Louis-Lhl/ECEN405_D_class_amp/schematic/input/inputStage.png

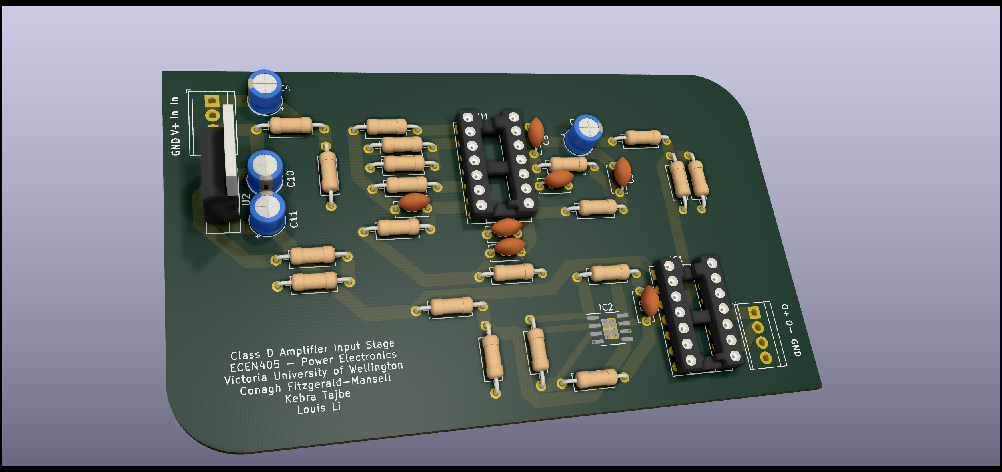
schematic/input/inputStage.png
