Louis-Lhl/ECEN405_D_class_amp/schematic/power/README.md

# Schematic

This folder contains the schematic and PCB layout files and the PCB Gerber files of the power amplifier. These were created using [Kicad](https://www.kicad.org/).

* The PCB Gerbers is [here]().
* The BOM is [here](power_ver_2.0/power_ver_2.0.csv).
