Louis-Lhl/ECEN405_D_class_amp/schematic/power/power_ver_2.0/power_ver_2.0.xlsx

Id;"Designator";"Package";"Quantity";"Designation";"Supplier and ref";
1;"C11 | C3";"C_Disc_D3.8mm_W2.6mm_P2.50mm";2;"SR205C104MAATR1";;;
2;"C10 | C2";"C_Disc_D3.8mm_W2.6mm_P2.50mm";2;"C324C106K3R5TA";;;
3;"C6 | C9 | C7";"C_Radial_D10.0mm_H12.5mm_P5.00mm";3;"uF";;;
4;"TP4 | TP3 | TP2 | TP1";"TestPoint_THTPad_D2.0mm_Drill1.0mm";4;"TestPoint";;;
5;"H4 | H3 | H2 | H1";"MountingHole_4.3mm_M4";4;"MountingHole";;;
6;"C8";"CP_Radial_D12.5mm_P5.00mm";1;"EEU-FC1H102L";;;
7;"R11 | R10";"R_Axial_DIN0207_L6.3mm_D2.5mm_P10.16mm_Horizontal";2;"470";;;
8;"R9 | R8 | R3 | R2";"R_Axial_DIN0207_L6.3mm_D2.5mm_P10.16mm_Horizontal";4;"100";;;
9;"R7 | R6 | R5 | R4";"R_Axial_DIN0207_L6.3mm_D2.5mm_P10.16mm_Horizontal";4;"10k";;;
10;"R1";"R_Axial_DIN0207_L6.3mm_D2.5mm_P10.16mm_Horizontal";1;"1K";;;
11;"L2 | L1";"L_Toroid_Vertical_L24.6mm_W15.5mm_P11.44mm_Pulse_KM-4";2;"2216-V-RC";;;
12;"J4";"TerminalBlock_Altech_AK300-2_P5.00mm";1;"Driver_power";;;
13;"J3";"TerminalBlock_Altech_AK300-2_P5.00mm";1;"Amp_Power";;;
14;"J2";"TerminalBlock_Altech_AK300-2_P5.00mm";1;"Audio OUTPUT";;;
15;"J1";"TerminalBlock_Altech_AK300-2_P5.00mm";1;"PWM INPUT";;;
16;"D6 | D5 | D4 | D3 | D2 | D1";"D_DO-35_SOD27_P7.62mm_Horizontal";6;"1N4148";;;
17;"C5 | C4";"CP_Radial_D6.3mm_P2.50mm";2;"ECE-A1HN100U";;;
18;"C1";"CP_Radial_D10.0mm_P5.00mm";1;"ECE-A1HN101U";;;
19;"Q4 | Q3 | Q2 | Q1";"TO-220-3";4;"IRF530A";;;
20;"U1";"DIP-16_W7.62mm";1;"HIP4082IP";;;
