Louis-Lhl/ECEN405_D_class_amp/results/power_section_measurement/30V_audio_Output/F0006CH1.CSV

Record Length | 2.500000e+03 | -0.012500000000 | -14.80000
Sample Interval | 1.000000e-05 | -0.012490000000 | -15.00000
Trigger Point | 1.250000000000e+03 | -0.012480000000 | -14.60000
 |  | -0.012470000000 | -15.00000
 |  | -0.012460000000 | -15.00000
 |  | -0.012450000000 | -14.60000
Source | CH1 | -0.012440000000 | -15.00000
Vertical Units | V | -0.012430000000 | -15.00000
Vertical Scale | 5.000000e+00 | -0.012420000000 | -14.80000
Vertical Offset | 0.000000e+00 | -0.012410000000 | -14.80000
Horizontal Units | s | -0.012400000000 | -14.80000
Horizontal Scale | 2.500000e-03 | -0.012390000000 | -14.80000
Pt Fmt | Y | -0.012380000000 | -14.60000
Yzero | 0.000000e+00 | -0.012370000000 | -14.80000
Probe Atten | 1.000000e+01 | -0.012360000000 | -14.60000
Model Number | TDS2024B | -0.012350000000 | -14.80000
Serial Number | C046999 | -0.012340000000 | -14.40000
Firmware Version | FV:v22.11 | -0.012330000000 | -14.80000
 |  | -00.012320000000 | -14.60000
 |  | -00.012310000000 | -14.60000
 |  | -00.012300000000 | -14.80000
 |  | -00.012290000000 | -14.60000
 |  | -00.012280000000 | -14.40000
 |  | -00.012270000000 | -14.60000
 |  | -00.012260000000 | -14.60000
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
