Louis-Lhl/ECEN405_D_class_amp/results/power_section_measurement/ALL0012/F0012CH1.CSV

Record Length | 2.500000e+03 | -0.012500000000 | -0.04000
Sample Interval | 1.000000e-05 | -0.012490000000 | -0.08000
Trigger Point | 1.250000000000e+03 | -0.012480000000 | -0.16000
 |  | -0.012470000000 | -0.16000
 |  | -0.012460000000 | -0.20000
 |  | -0.012450000000 | -0.12000
Source | CH1 | -0.012440000000 | -0.24000
Vertical Units | V | -0.012430000000 | -0.28000
Vertical Scale | 1.000000e+00 | -0.012420000000 | -0.28000
Vertical Offset | 4.000000e-02 | -0.012410000000 | -0.32000
Horizontal Units | s | -0.012400000000 | -0.36000
Horizontal Scale | 2.500000e-03 | -0.012390000000 | -0.36000
Pt Fmt | Y | -0.012380000000 | -0.40000
Yzero | 0.000000e+00 | -0.012370000000 | -0.44000
Probe Atten | 1.000000e+01 | -0.012360000000 | -0.44000
Model Number | TDS2024B | -0.012350000000 | -0.48000
Serial Number | C046999 | -0.012340000000 | -0.52000
Firmware Version | FV:v22.11 | -0.012330000000 | -0.52000
 |  | -00.012320000000 | -0.56000
 |  | -00.012310000000 | -0.68000
 |  | -00.012300000000 | -0.60000
 |  | -00.012290000000 | -0.64000
 |  | -00.012280000000 | -0.68000
 |  | -00.012270000000 | -0.72000
 |  | -00.012260000000 | -0.72000
 |  | -00.012250000000 | -0.76000
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
