Louis-Lhl/ECEN405_D_class_amp/results/power_section_measurement/ALL0013/F0013CH1.CSV

Record Length | 2.500000e+03 | -0.002500000000 | -0.08000
Sample Interval | 2.000000e-06 | -0.002498000000 | -0.08000
Trigger Point | 1.250000000000e+03 | -0.002496000000 | -0.08000
 |  | -0.002494000000 | -0.08000
 |  | -0.002492000000 | -0.08000
 |  | -0.002490000000 | -0.12000
Source | CH1 | -0.002488000000 | -0.08000
Vertical Units | V | -0.002486000000 | -0.12000
Vertical Scale | 1.000000e+00 | -0.002484000000 | -0.12000
Vertical Offset | 4.000000e-02 | -0.002482000000 | -0.12000
Horizontal Units | s | -0.002480000000 | -0.12000
Horizontal Scale | 5.000000e-04 | -0.002478000000 | -0.12000
Pt Fmt | Y | -0.002476000000 | -0.08000
Yzero | 0.000000e+00 | -0.002474000000 | -0.12000
Probe Atten | 1.000000e+01 | -0.002472000000 | -0.16000
Model Number | TDS2024B | -0.002470000000 | -0.16000
Serial Number | C046999 | -0.002468000000 | -0.12000
Firmware Version | FV:v22.11 | -0.002466000000 | -0.12000
 |  | -00.002464000000 | -0.16000
 |  | -00.002462000000 | -0.20000
 |  | -00.002460000000 | -0.20000
 |  | -00.002458000000 | -0.20000
 |  | -00.002456000000 | -0.20000
 |  | -00.002454000000 | -0.16000
 |  | -00.002452000000 | -0.20000
 |  | -00.002450000000 | -0.20000
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
