Louis-Lhl/ECEN405_D_class_amp/results/power_section_measurement/PWM_input/F0004CH1.CSV

Record Length | 2.500000e+03 | -0.000050000000 | 4.40000
Sample Interval | 4.000000e-08 | -0.000049960000 | 4.60000
Trigger Point | 1.250000000000e+03 | -0.000049920000 | 4.80000
 |  | -0.000049880000 | 4.40000
 |  | -0.000049840000 | 4.80000
 |  | -0.000049800000 | 5.00000
Source | CH1 | -0.000049760000 | 4.60000
Vertical Units | V | -0.000049720000 | 4.80000
Vertical Scale | 5.000000e+00 | -0.000049680000 | 4.80000
Vertical Offset | 1.000000e+01 | -0.000049640000 | 4.80000
Horizontal Units | s | -0.000049600000 | 4.80000
Horizontal Scale | 1.000000e-05 | -0.000049560000 | 4.60000
Pt Fmt | Y | -0.000049520000 | 4.80000
Yzero | 0.000000e+00 | -0.000049480000 | 4.80000
Probe Atten | 1.000000e+01 | -0.000049440000 | 5.00000
Model Number | TDS2024B | -0.000049400000 | 5.00000
Serial Number | C046999 | -0.000049360000 | 4.80000
Firmware Version | FV:v22.11 | -0.000049320000 | 4.60000
 |  | -00.000049280000 | 4.80000
 |  | -00.000049240000 | 5.00000
 |  | -00.000049200000 | 4.60000
 |  | -00.000049160000 | 4.60000
 |  | -00.000049120000 | 4.80000
 |  | -00.000049080000 | 5.00000
 |  | -00.000049040000 | 4.80000
 |  | -00.000049000000 | 4.60000
 |  | -00.000048960000 | 4.60000
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
