Louis-Lhl/ECEN405_D_class_amp/results/power_section_measurement/PWM_input/F0004CH2.CSV

Record Length | 2.500000e+03 | -0.000050000000 | 0.20000
Sample Interval | 4.000000e-08 | -0.000049960000 | 0.20000
Trigger Point | 1.250000000000e+03 | -0.000049920000 | 0.40000
 |  | -0.000049880000 | 0.60000
 |  | -0.000049840000 | 0.60000
 |  | -0.000049800000 | 0.20000
Source | CH2 | -0.000049760000 | 0.00000
Vertical Units | A | -0.000049720000 | -0.20000
Vertical Scale | 5.000000e+00 | -0.000049680000 | 0.20000
Vertical Offset | -1.000000e+01 | -0.000049640000 | 0.40000
Horizontal Units | s | -0.000049600000 | 0.20000
Horizontal Scale | 1.000000e-05 | -0.000049560000 | 0.40000
Pt Fmt | Y | -0.000049520000 | 0.20000
Yzero | 0.000000e+00 | -0.000049480000 | 0.40000
Probe Atten | 1.000000e+01 | -0.000049440000 | 0.20000
Model Number | TDS2024B | -0.000049400000 | 0.40000
Serial Number | C046999 | -0.000049360000 | 0.20000
Firmware Version | FV:v22.11 | -0.000049320000 | 0.00000
 |  | -00.000049280000 | 0.20000
 |  | -00.000049240000 | 0.00000
 |  | -00.000049200000 | 0.40000
 |  | -00.000049160000 | 0.00000
 |  | -00.000049120000 | 0.40000
 |  | -00.000049080000 | 0.40000
 |  | -00.000049040000 | 0.20000
 |  | -00.000049000000 | 0.20000
 |  | -00.000048960000 | 0.60000
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
