Louis-Lhl/ECEN405_D_class_amp/results/power_section_measurement/PWM_output_across_load/F0015CH1.CSV

Record Length | 2.500000e+03 | -0.000012500000 | 12.80000
Sample Interval | 1.000000e-08 | -0.000012490000 | 13.60000
Trigger Point | 1.250000000000e+03 | -0.000012480000 | 13.60000
 |  | -0.000012470000 | 14.40000
 |  | -0.000012460000 | 13.60000
 |  | -0.000012450000 | 13.60000
Source | CH1 | -0.000012440000 | 14.40000
Vertical Units | V | -0.000012430000 | 14.40000
Vertical Scale | 2.000000e+01 | -0.000012420000 | 13.60000
Vertical Offset | 0.000000e+00 | -0.000012410000 | 14.40000
Horizontal Units | s | -0.000012400000 | 13.60000
Horizontal Scale | 2.500000e-06 | -0.000012390000 | 14.40000
Pt Fmt | Y | -0.000012380000 | 14.40000
Yzero | 0.000000e+00 | -0.000012370000 | 15.20000
Probe Atten | 1.000000e+01 | -0.000012360000 | 13.60000
Model Number | TDS2024B | -0.000012350000 | 12.80000
Serial Number | C046999 | -0.000012340000 | 13.60000
Firmware Version | FV:v22.11 | -0.000012330000 | 13.60000
 |  | -00.000012320000 | 14.40000
 |  | -00.000012310000 | 13.60000
 |  | -00.000012300000 | 13.60000
 |  | -00.000012290000 | 13.60000
 |  | -00.000012280000 | 14.40000
 |  | -00.000012270000 | 14.40000
 |  | -00.000012260000 | 13.60000
 |  | -00.000012250000 | 14.40000
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
