Louis-Lhl/ECEN405_D_class_amp/results/inputFilter/250034087_1454181184963633_4800908642251497282_n.jpg

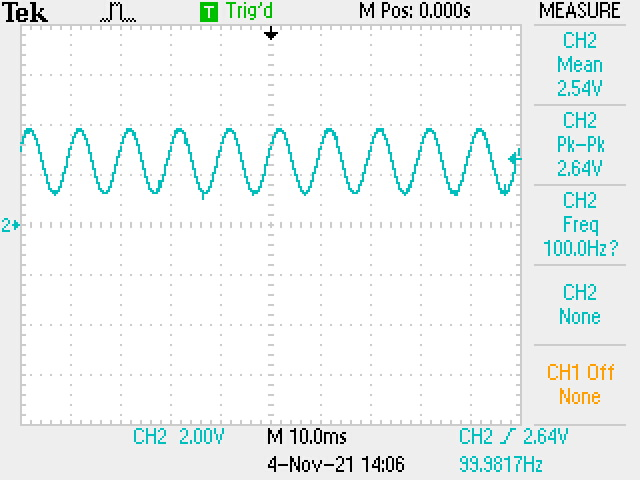
results/inputFilter/250034087_1454181184963633_4800908642251497282_n.jpg
