Louis-Lhl/ECEN405_D_class_amp/results/inputFilter/250767801_211799224394181_3932051920103736763_n.jpg

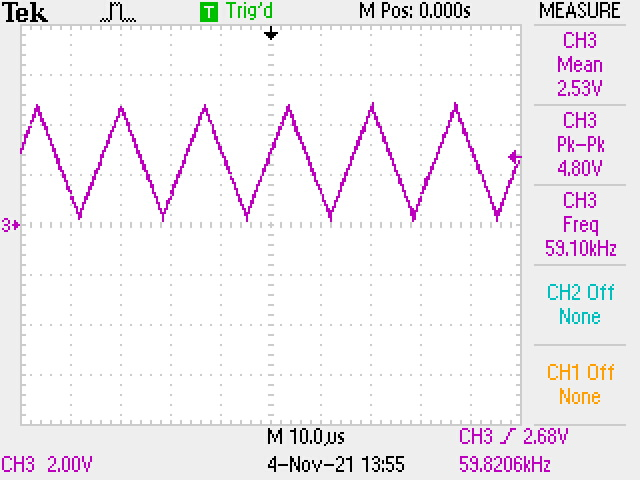
results/inputFilter/250767801_211799224394181_3932051920103736763_n.jpg
