Louis-Lhl/ECEN405_D_class_amp/results/inputFilter/251312043_1243758189444691_4574539768760520797_n.png

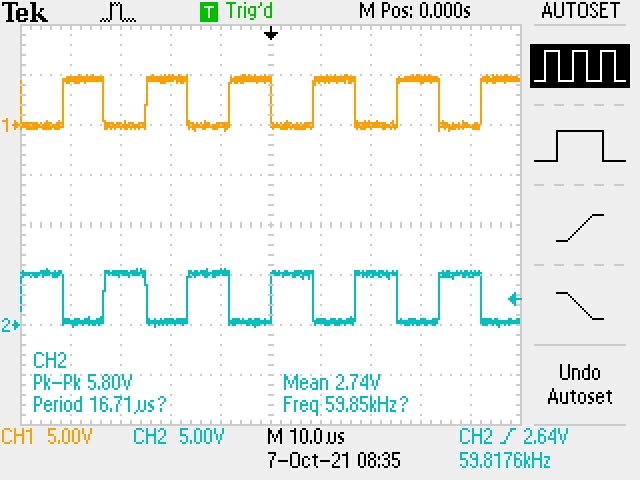
results/inputFilter/251312043_1243758189444691_4574539768760520797_n.png
