Louis-Lhl/ECEN405_D_class_amp/results/inputFilter/251569185_559348848496102_8192376683480866225_n.jpg

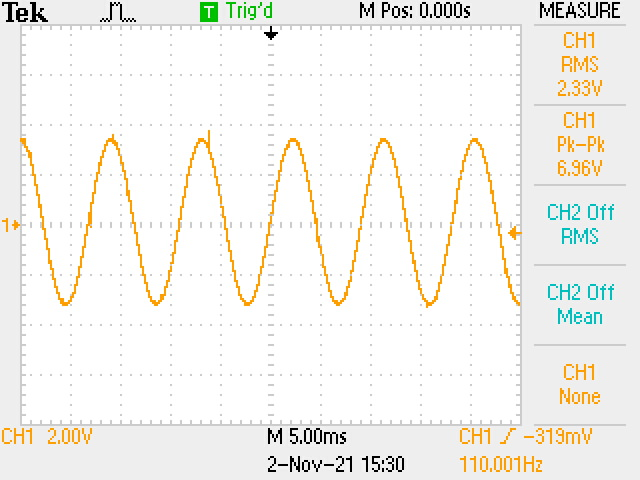
results/inputFilter/251569185_559348848496102_8192376683480866225_n.jpg
