Louis-Lhl/ECEN405_D_class_amp/results/inputFilter/253176706_352466729969639_4853334996477210062_n.jpg

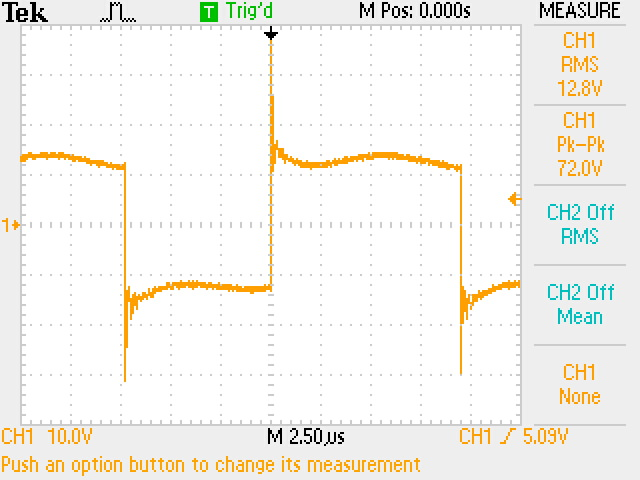
results/inputFilter/253176706_352466729969639_4853334996477210062_n.jpg
