Louis-Lhl/ECEN405_D_class_amp/results/outputFilter/OutputFilter.png

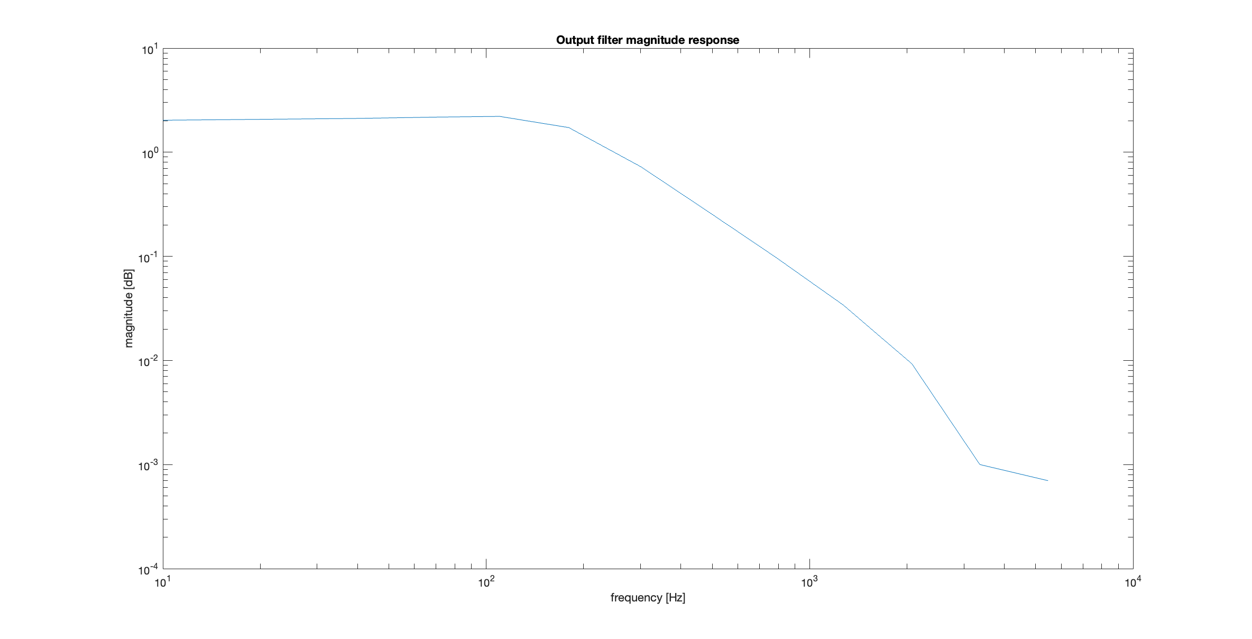
results/outputFilter/OutputFilter.png
