Louis-Lhl/ECEN405_D_class_amp/results/power_section_measurement/30V_audio_Output/F0006TEK.JPG

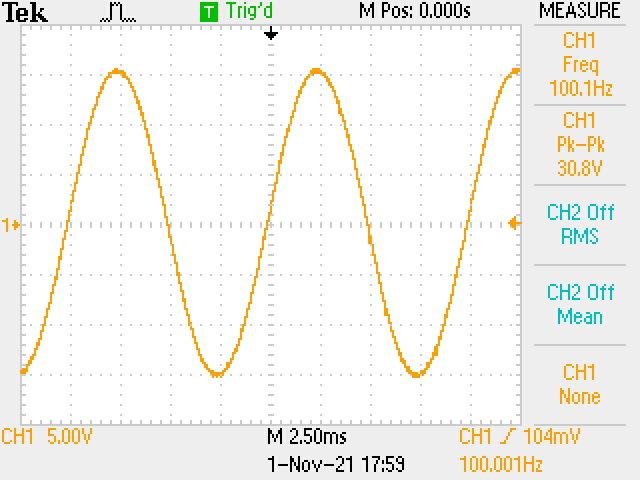
results/power_section_measurement/30V_audio_Output/F0006TEK.JPG
