Louis-Lhl/ECEN405_D_class_amp/results/power_section_measurement/ALL0012/F0012TEK.JPG

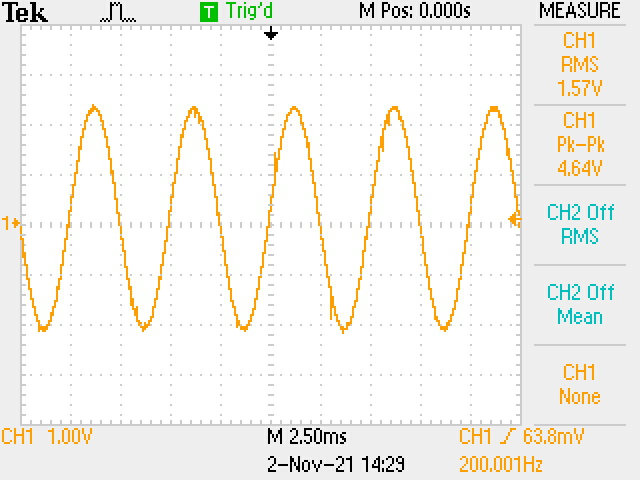
results/power_section_measurement/ALL0012/F0012TEK.JPG
