Louis-Lhl/ECEN405_D_class_amp/results/power_section_measurement/ALL0013/F0013TEK.JPG

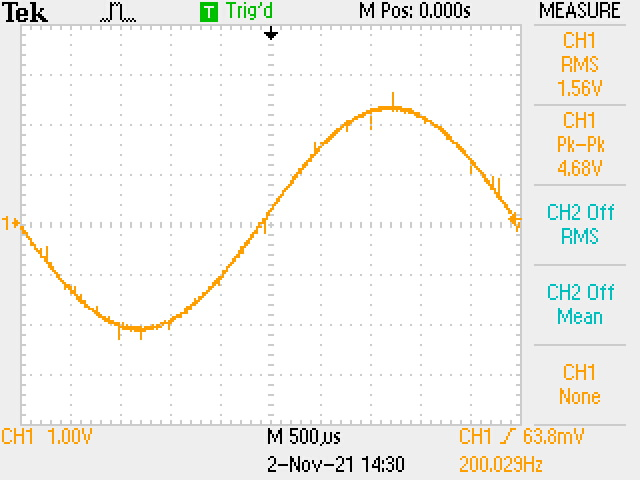
results/power_section_measurement/ALL0013/F0013TEK.JPG
