Louis-Lhl/ECEN405_D_class_amp/results/power_section_measurement/amplified_PWM_output/F0011TEK.JPG

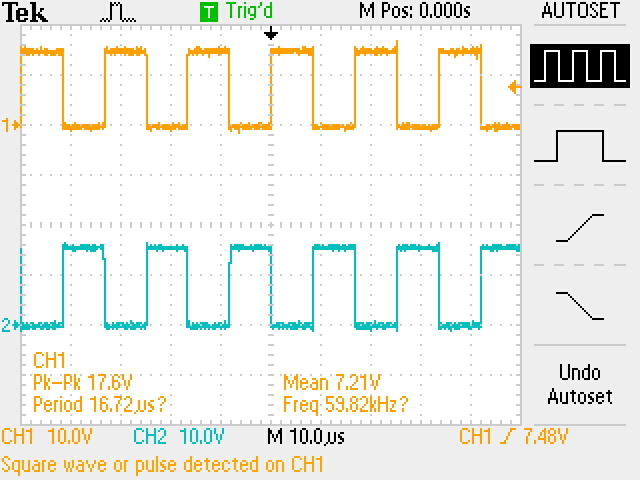
results/power_section_measurement/amplified_PWM_output/F0011TEK.JPG
