Louis-Lhl/ECEN405_D_class_amp/results/power_section_measurement/amplified_PWM_output_overlay/F0007TEK.JPG

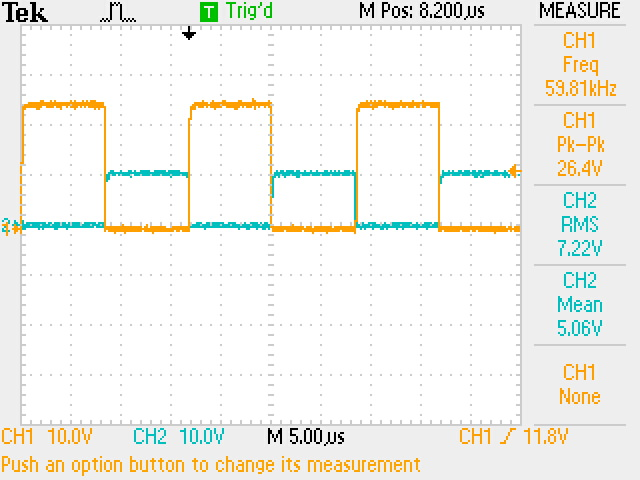
results/power_section_measurement/amplified_PWM_output_overlay/F0007TEK.JPG
