Louis-Lhl/ECEN405_D_class_amp/results/power_section_measurement/audio_output_across_load/F0014TEK.JPG

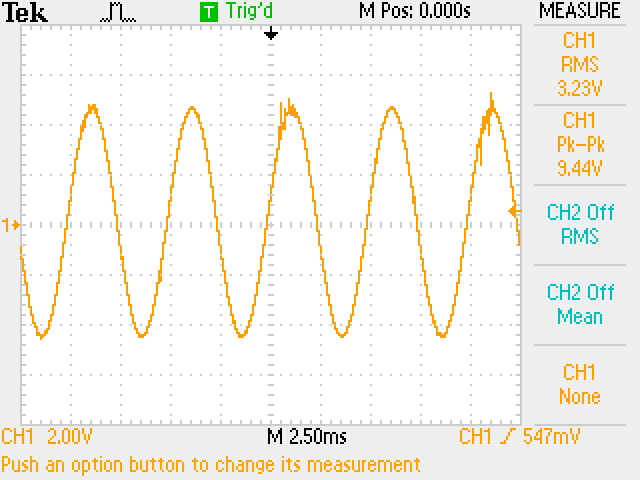
results/power_section_measurement/audio_output_across_load/F0014TEK.JPG
