Louis-Lhl/ECEN405_D_class_amp/results/power_section_measurement/dead_time_1/F0009TEK.JPG

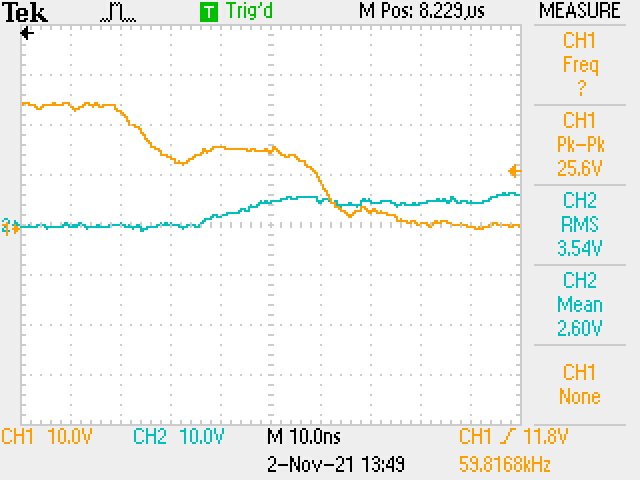
results/power_section_measurement/dead_time_1/F0009TEK.JPG
