Louis-Lhl/ECEN405_D_class_amp/results/power_section_measurement/dead_time_2/F0010TEK.JPG

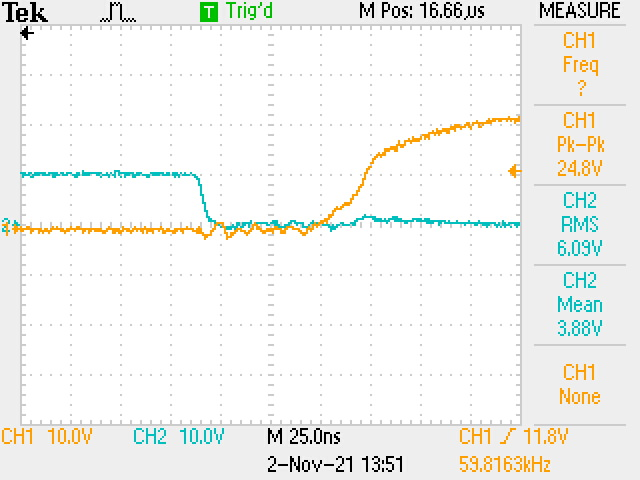
results/power_section_measurement/dead_time_2/F0010TEK.JPG
