Louis-Lhl/ECEN405_D_class_amp/results/power_section_measurement/PWM_input/F0004TEK.JPG

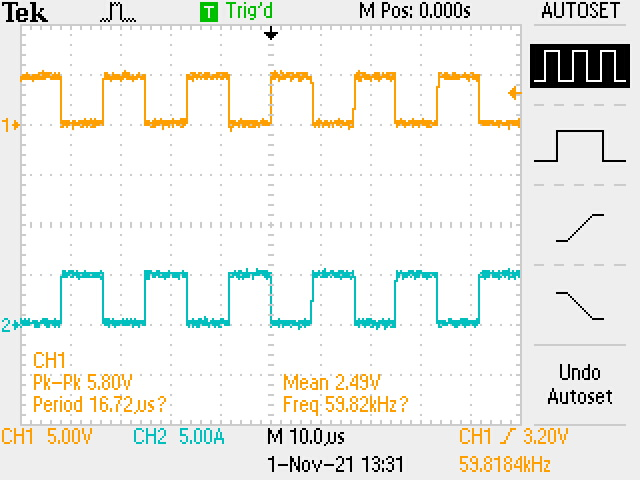
results/power_section_measurement/PWM_input/F0004TEK.JPG
