Louis-Lhl/ECEN405_D_class_amp/results/power_section_measurement/PWM_output_across_load/F0015TEK.JPG

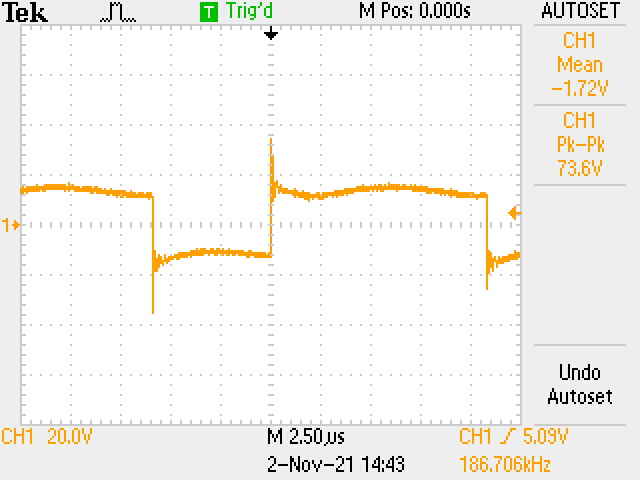
results/power_section_measurement/PWM_output_across_load/F0015TEK.JPG
