Louis-Lhl/ECEN405_D_class_amp/results/system/SystemEff.png

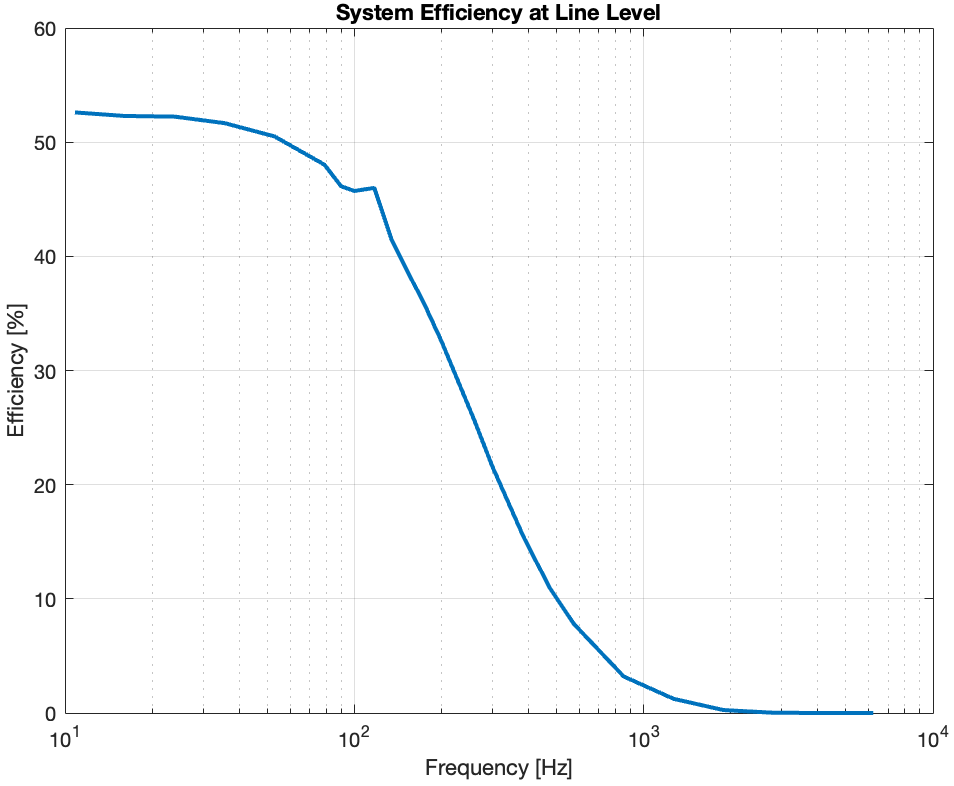
results/system/SystemEff.png
