Louis-Lhl/ECEN405_D_class_amp/results/system/SystemGain.png

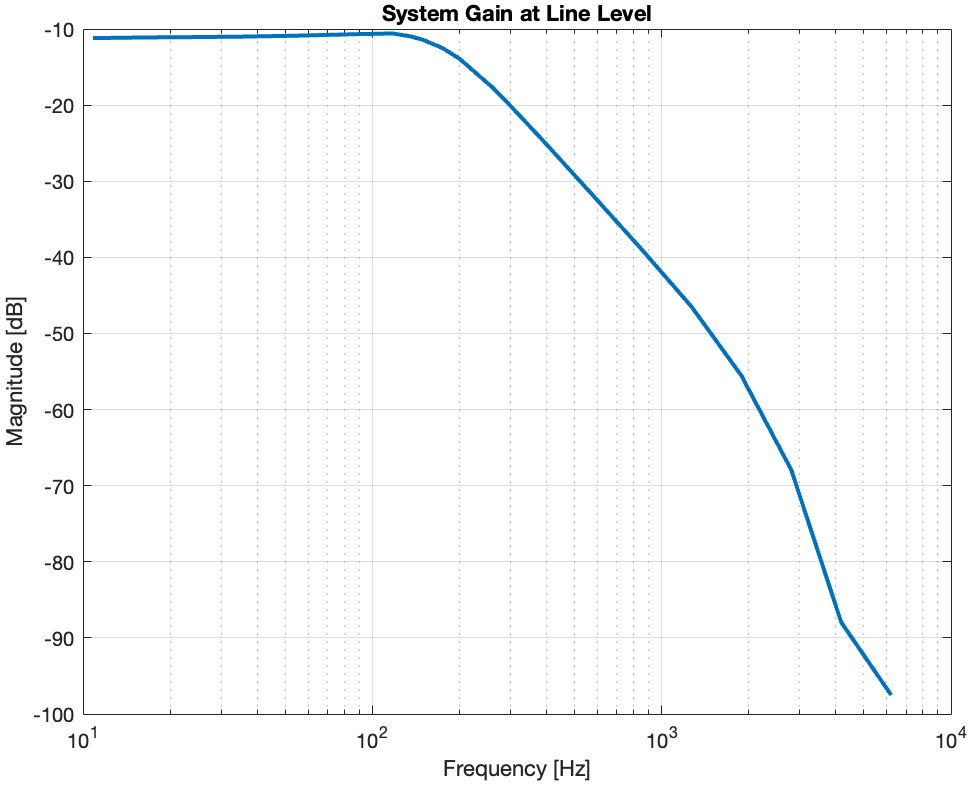
results/system/SystemGain.png
