Louis-Lhl/ECEN405_D_class_amp/results/system/SystemPower.png

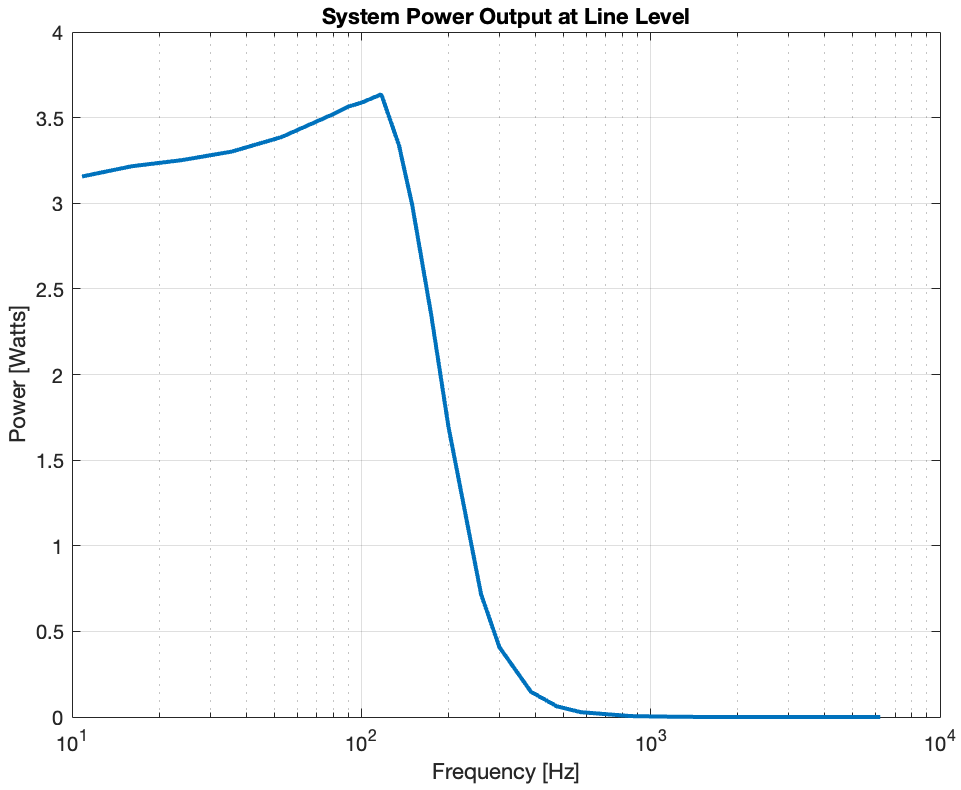
results/system/SystemPower.png
