Louis-Lhl/ECEN405_D_class_amp/results/system/SystemTHD.png

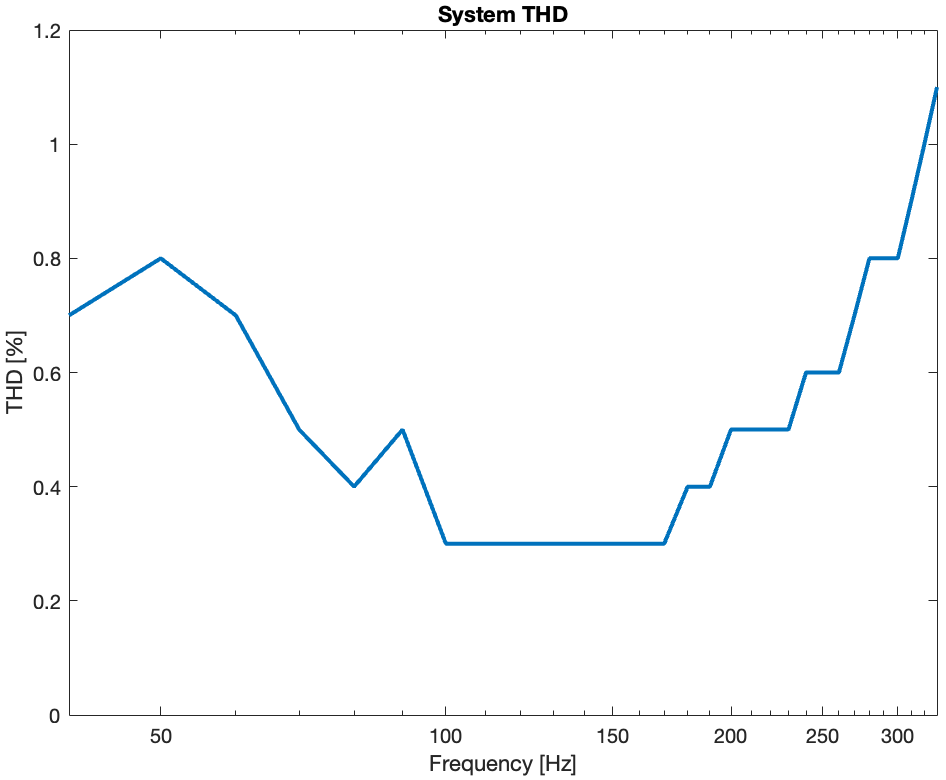
results/system/SystemTHD.png
