Louis-Lhl/ECEN405_D_class_amp/schematic/filter/filterSim.asc

C1: cap; 260µ
C2: polcap; 56µ
C3: polcap; 56µ
L1: ind; 2.2m
L2: ind; 2.2m
R1: res; 4
V1: voltage; SINE(0 2 400)
V2: voltage; SINE(7.5 5 100); AC 1
V3: voltage; SINE(0 2 400 0 0 90)
V4: voltage; SINE(7.5 5 100 0 0 180); AC 1 180
Named nets: 0, Out-, Out+
.ac dec 100 1 10000
.tran 100 0.1
