Louis-Lhl/ECEN405_D_class_amp/(list of files, drawings)

Other design files:
schematic/joint_pcb_ver2/joint_pcb.dsn
schematic/power/power_ver_2.0/power_ver_2.0.dsn
schematic/power/power_ver_3.0/power_ver_3.0.dsn
