Louis-Lhl/ECEN405_D_class_amp/schematic/joint_pcb_ver2/joint_pcb.kicad_pcb

## KiCad design schematic/joint_pcb_ver2/joint_pcb.kicad_pcb (2021-09-13)

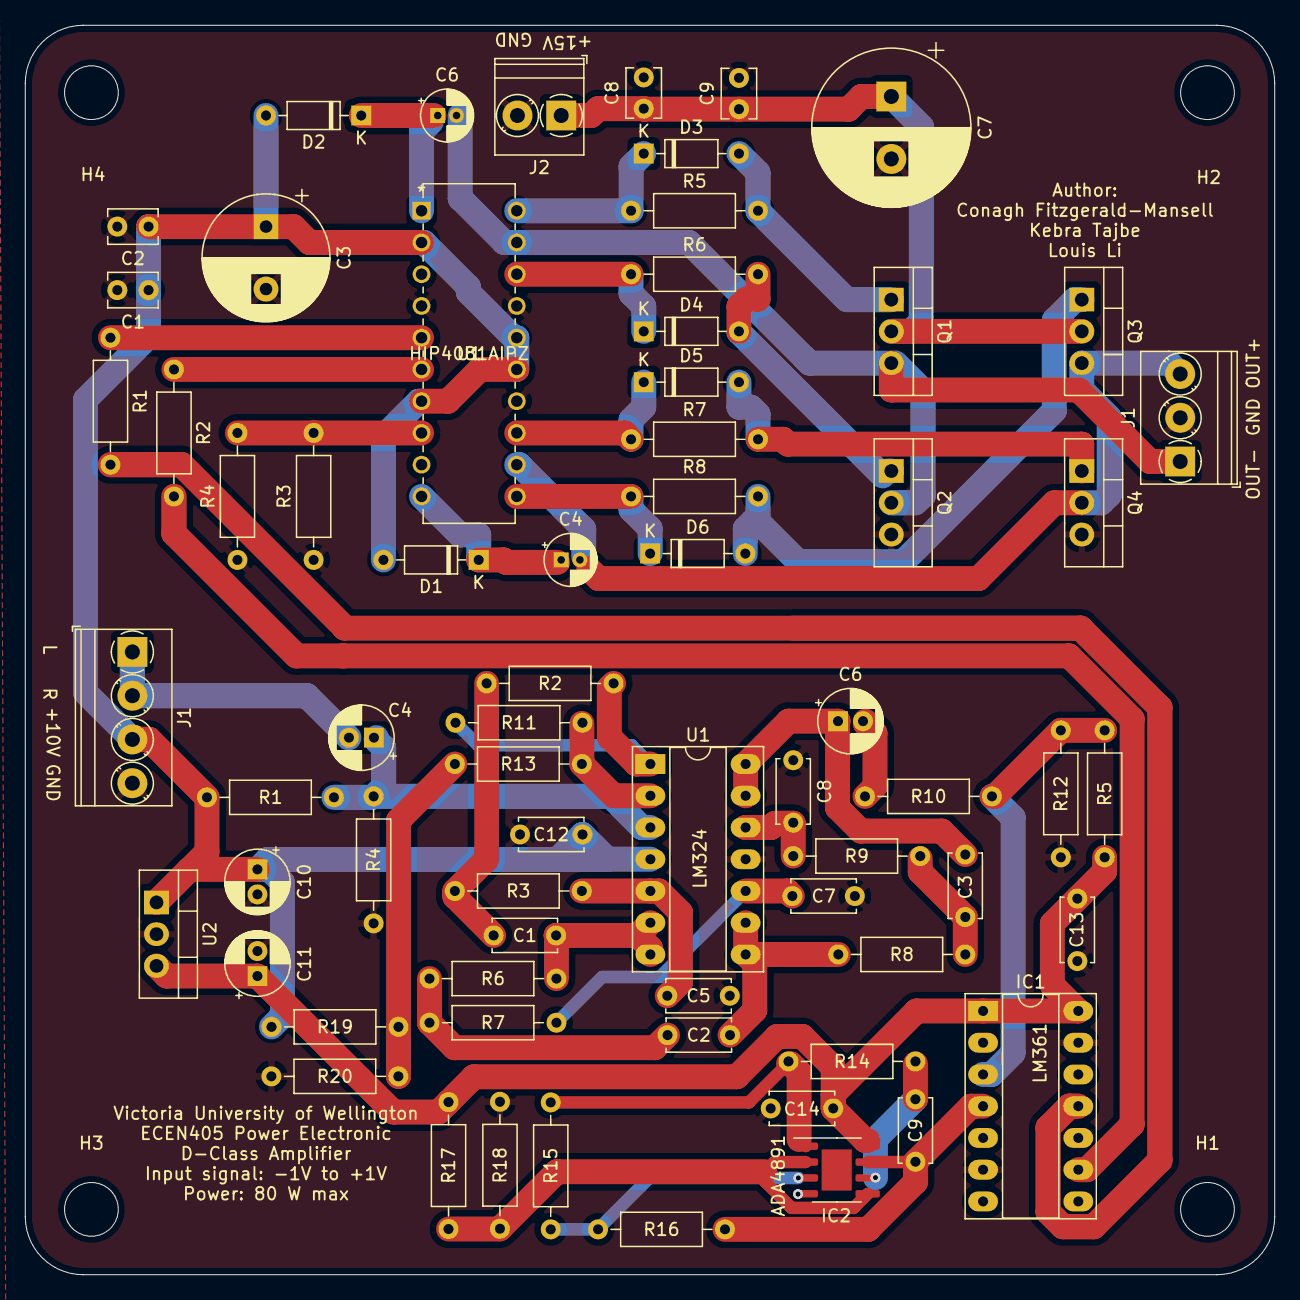
[picture p45: board joint_pcb.kicad_pcb from above]

Board: 2 copper layers, 100.0 x 100.0 mm, 72 parts (0 on the bottom side), 41 nets.

Parts:
C1: 47n; C_Disc_D5.0mm_W2.5mm_P5.00mm
C1#2, C8#2: 10uF; C_Disc_D3.8mm_W2.6mm_P2.50mm
C2, C3: 56n; C_Disc_D5.0mm_W2.5mm_P5.00mm
C2#2, C9#2: 0.1uF; C_Disc_D3.8mm_W2.6mm_P2.50mm
C3#2: 100uF; CP_Radial_D10.0mm_P5.00mm
C4, C6: 100u; CP_Radial_D5.0mm_P2.00mm
C4#2, C6#2: 1uF; CP_Radial_D4.0mm_P1.50mm
C5, C9: 4.7n; C_Disc_D5.0mm_W2.5mm_P5.00mm
C7, C8: 5.6n; C_Disc_D5.0mm_W2.5mm_P5.00mm
C7#2: 1000uF; CP_Radial_D12.5mm_P5.00mm
C10, C11: 10u; CP_Radial_D5.0mm_P2.00mm
C12, C13, C14: 100nF; C_Disc_D5.0mm_W2.5mm_P5.00mm
D1, D2, D3, D4, D5, D6: 1N4148; D_DO-35_SOD27_P7.62mm_Horizontal
H1, H2, H3, H4: MountingHole; MountingHole_4.3mm_M4
IC1: LM361N_NOPB; DIP-14_W7.62mm_Socket_LongPads
IC2: ADA4891-2ARMZ-R7; SOIC-8-1EP_3.9x4.9mm_P1.27mm_EP2.41x3.3mm
J1: Screw_Terminal_01x04; TerminalBlock_Phoenix_PT-1,5-4-3.5-H_1x04_P3.50mm_Horizontal
J1#2: Power_PWM_output; TerminalBlock_Phoenix_PT-1,5-3-3.5-H_1x03_P3.50mm_Horizontal
J2: Amp_power; TerminalBlock_Phoenix_PT-1,5-2-3.5-H_1x02_P3.50mm_Horizontal
Q1, Q2, Q3, Q4: IRF510PBF; TO-220-3_Vertical
R1, R5, R10, R12, R15, R17, R18, R19: 10k; R_Axial_DIN0207_L6.3mm_D2.5mm_P10.16mm_Horizontal
R1#2, R2#2: 470R; R_Axial_DIN0207_L6.3mm_D2.5mm_P10.16mm_Horizontal
R2, R13: 1.2k; R_Axial_DIN0207_L6.3mm_D2.5mm_P10.16mm_Horizontal
R3, R16: 8.2k; R_Axial_DIN0207_L6.3mm_D2.5mm_P10.16mm_Horizontal
R3#2, R4#2: 47kR; R_Axial_DIN0207_L6.3mm_D2.5mm_P10.16mm_Horizontal
R4, R14, R20: 1k; R_Axial_DIN0207_L6.3mm_D2.5mm_P10.16mm_Horizontal
R5#2, R6#2, R7#2, R8#2: 100R; R_Axial_DIN0207_L6.3mm_D2.5mm_P10.16mm_Horizontal
R6: 680; R_Axial_DIN0207_L6.3mm_D2.5mm_P10.16mm_Horizontal
R7: 15k; R_Axial_DIN0207_L6.3mm_D2.5mm_P10.16mm_Horizontal
R8: 560; R_Axial_DIN0207_L6.3mm_D2.5mm_P10.16mm_Horizontal
R9: 18k; R_Axial_DIN0207_L6.3mm_D2.5mm_P10.16mm_Horizontal
R11: 5.6k; R_Axial_DIN0207_L6.3mm_D2.5mm_P10.16mm_Horizontal
U1: LM324; DIP-14_W7.62mm_Socket_LongPads
U1#2: HIP4081AIPZ
U2: LM7805_TO220; TO-220-3_Vertical

Connections:
+5V: C11.1, C13.1, C14.1, IC1.1, IC1.14, IC2.8, R5.1, R17.1, U2.3
+15V: C7#2.1, C8#2.1, C9#2.1, J2.1, Q1.2, Q3.2
AHO: D6.1, R8#2.1, U1#2.11
AHS: C4#2.2, J1#2.3, Q3.3, Q4.2, U1#2.12
ALO: D5.1, R7#2.1, U1#2.13
BHO: D3.1, R5#2.1, U1#2.20
BHS: C6#2.2, J1#2.1, Q1.3, Q2.2, U1#2.19
BLO: D4.1, R6#2.1, U1#2.18
Bias: R13.1, R19.2, R20.1
GND: C1#2.2, C2#2.2, C3#2.2, C5.2, C7.1, C7#2.2, C8.1, C8#2.2, C9#2.2, C10.2, C11.2, C12.2, C13.2, C14.2, IC1.6, IC1.8, IC1.10, IC1.13, IC2.4, J1.4, J1#2.2, J2.2, Q2.3, Q4.3, R3#2.1, R4.2, R4#2.1, R12.2, R18.2, R20.2, U1.11, U1#2.4, U1#2.14, U1#2.17, U2.2
Input: C4.2, J1.1, J1.2
unnamed: C1.1, R6.2, U1.6, U1.7
unnamed: C1.2, R2.1, R3.2
unnamed: C2.1, R6.1, R7.2
unnamed: C2.2, R8.2, U1.8, U1.9
unnamed: C3.1, C6.1, U1.13, U1.14
unnamed: C3.2, R8.1, R9.2
unnamed: C4.1, C4#2.1, D1.1, R1.2, R4.1, U1.3, U1#2.10
unnamed: C5.1, R3.1, U1.5
unnamed: C6#2.1, D2.1, U1#2.1
unnamed: C6.2, R10.1
unnamed: C7.2, R7.1, U1.10
unnamed: C8.2, R9.1, U1.12
unnamed: C9.1, IC1.4, IC2.7, R16.1
unnamed: C9.2, IC2.6, R14.1
unnamed: D3.2, Q1.1, R5#2.2
unnamed: D4.2, Q2.1, R6#2.2
unnamed: D5.2, Q4.1, R7#2.2
unnamed: D6.2, Q3.1, R8#2.2
unnamed: IC2.1, R14.2, R15.2
unnamed: IC2.3, R15.1, R16.2
unnamed: R1#2.1, U1#2.5
unnamed: R2#2.1, U1#2.6
unnamed: R3#2.2, R4#2.2, U1#2.8
unnamed: R2.2, R11.1, U1.1
unnamed: R11.2, R13.2, U1.2
PWM+: IC1.11, R1#2.2
PWM-: IC1.9, R2#2.2
Vcc: C1#2.1, C2#2.1, C3#2.1, C10.1, C12.1, D1.2, D2.2, J1.3, R1.1, R19.1, U1.4, U1#2.2, U1#2.7, U1#2.15, U1#2.16, U2.1
Vref: IC2.2, IC2.5, R17.2, R18.1
filterOut: IC1.3, R5.2, R10.2, R12.1
