Louis-Lhl/ECEN405_D_class_amp/schematic/power/power_ver_3.0/power_ver_3.0.kicad_pcb

## KiCad design schematic/power/power_ver_3.0/power_ver_3.0.kicad_pcb (2021-09-13)

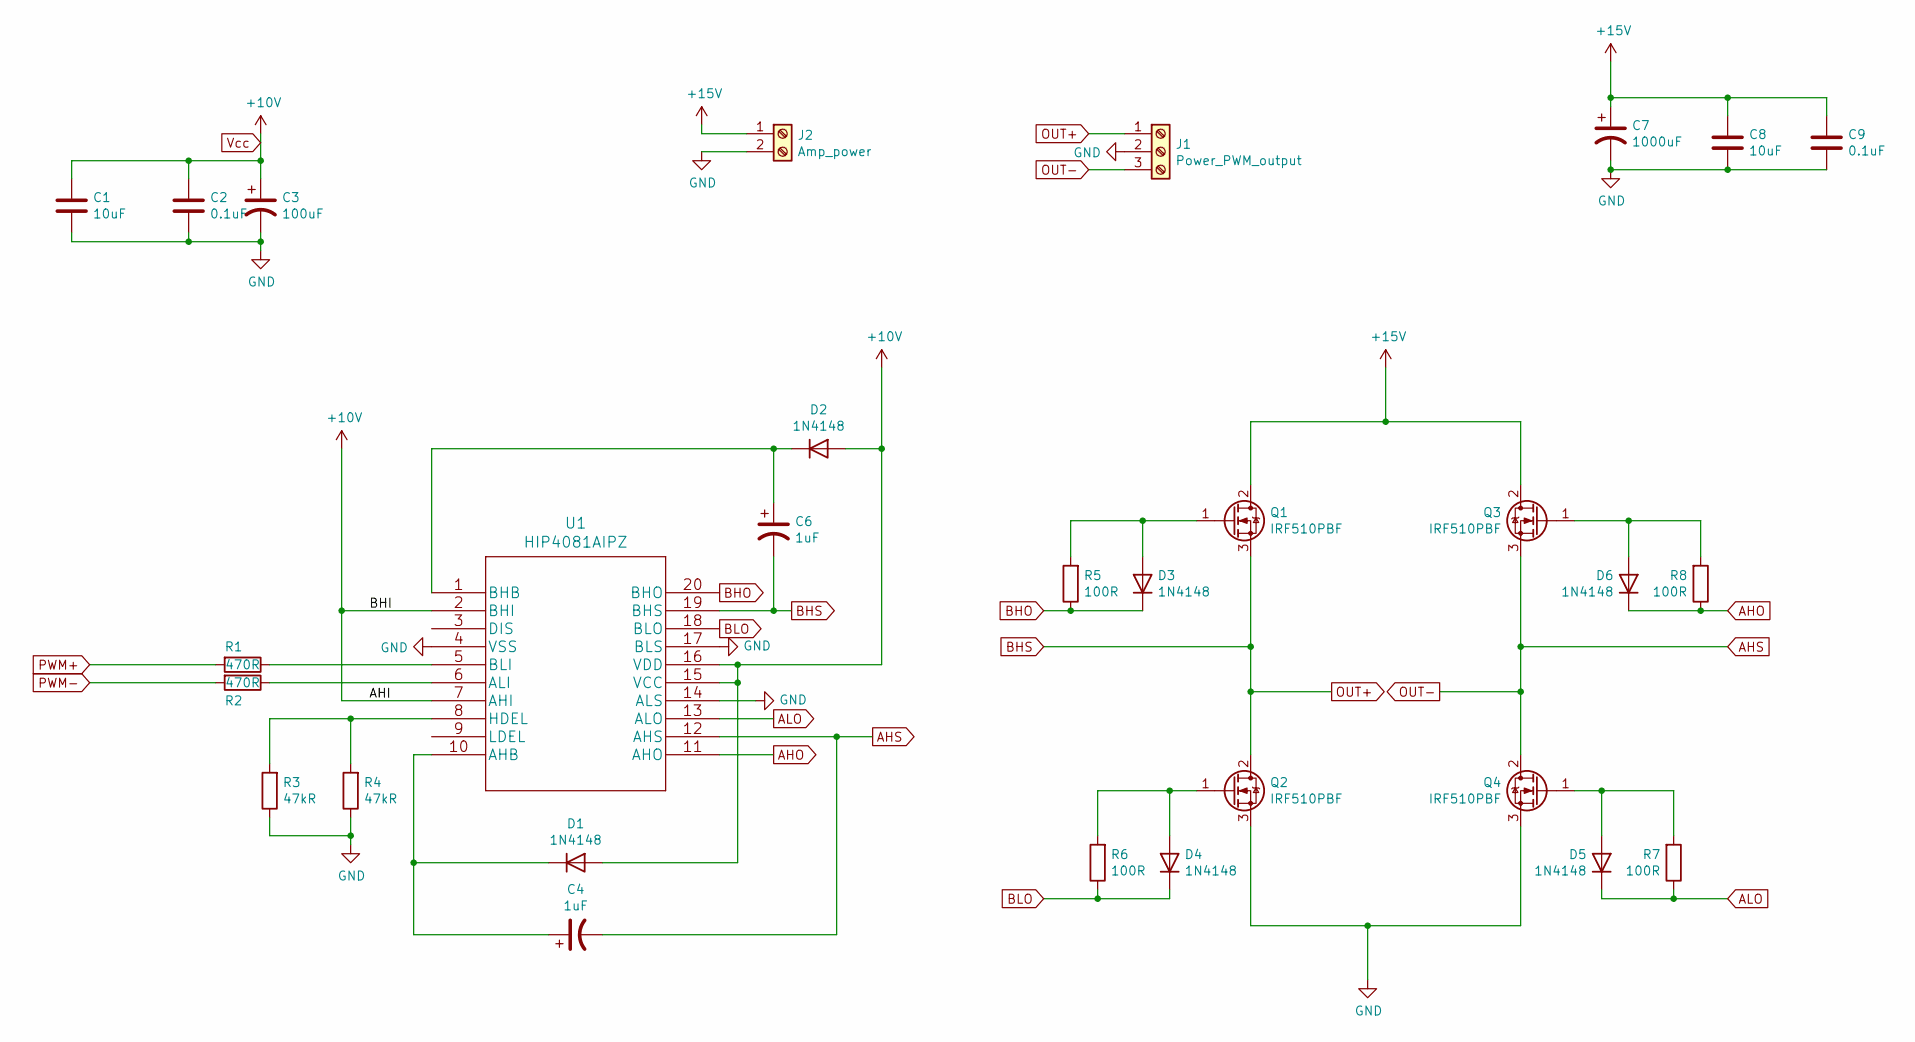
[picture p46: schematic power_ver_3.0.sch]

Parts:
C1, C8: 10uF; C_Disc_D3.8mm_W2.6mm_P2.50mm; MPN C324C106K3R5TA
C2, C9: 0.1uF; C_Disc_D3.8mm_W2.6mm_P2.50mm; MPN K104Z15Y5VE5TL2
C3: 100uF; CP_Radial_D10.0mm_P5.00mm; MPN ECE-A1HN101U
C4, C6: 1uF; CP_Radial_D4.0mm_P1.50mm; MPN ESS105M050AB2EA
C7: 1000uF; CP_Radial_D12.5mm_P5.00mm; MPN EEU-FC1H102L
D1, D2, D3, D4, D5, D6: 1N4148; D_DO-35_SOD27_P7.62mm_Horizontal; MPN 1N4148
J1: Power_PWM_output; TerminalBlock_Phoenix_PT-1,5-3-3.5-H_1x03_P3.50mm_Horizontal
J2: Amp_power; TerminalBlock_Phoenix_PT-1,5-2-3.5-H_1x02_P3.50mm_Horizontal
Q1, Q2, Q3, Q4: IRF510PBF; TO-220-3_Vertical
R1, R2: 470R; R_Axial_DIN0207_L6.3mm_D2.5mm_P10.16mm_Horizontal; MPN CFR-25JB-52-470R
R3, R4: 47kR; R_Axial_DIN0207_L6.3mm_D2.5mm_P10.16mm_Horizontal
R5, R6, R7, R8: 100R; R_Axial_DIN0207_L6.3mm_D2.5mm_P10.16mm_Horizontal; MPN CFR-25JR-52-100R
U1: HIP4081AIPZ

Connections:
+15V: C7.1, C8.1, C9.1, J2.1, Q1.2 (D), Q3.2 (D)
AHO: D6.1 (K), R8.1, U1.11 (AHO)
AHS: C4.2, J1.3, Q3.3 (S), Q4.2 (D), U1.12 (AHS)
ALO: D5.1 (K), R7.1, U1.13 (ALO)
BHO: D3.1 (K), R5.1, U1.20 (BHO)
BHS: C6.2, J1.1, Q1.3 (S), Q2.2 (D), U1.19 (BHS)
BLO: D4.1 (K), R6.1, U1.18 (BLO)
GND: C1.2, C2.2, C3.2, C7.2, C8.2, C9.2, J1.2, J2.2, Q2.3 (S), Q4.3 (S), R3.1, R4.1, U1.4 (VSS), U1.14 (ALS), U1.17 (BLS)
unnamed: C4.1, D1.1 (K), U1.10 (AHB)
unnamed: C6.1, D2.1 (K), U1.1 (BHB)
unnamed: D3.2 (A), Q1.1 (G), R5.2
unnamed: D4.2 (A), Q2.1 (G), R6.2
unnamed: D5.2 (A), Q4.1 (G), R7.2
unnamed: D6.2 (A), Q3.1 (G), R8.2
unnamed: R1.1, U1.5 (BLI)
unnamed: R2.1, U1.6 (ALI)
unnamed: R3.2, R4.2, U1.8 (HDEL)
PWM+: R1.2
PWM-: R2.2
Vcc: C1.1, C2.1, C3.1, D1.2 (A), D2.2 (A), U1.2 (BHI), U1.7 (AHI), U1.15 (VCC), U1.16 (VDD)

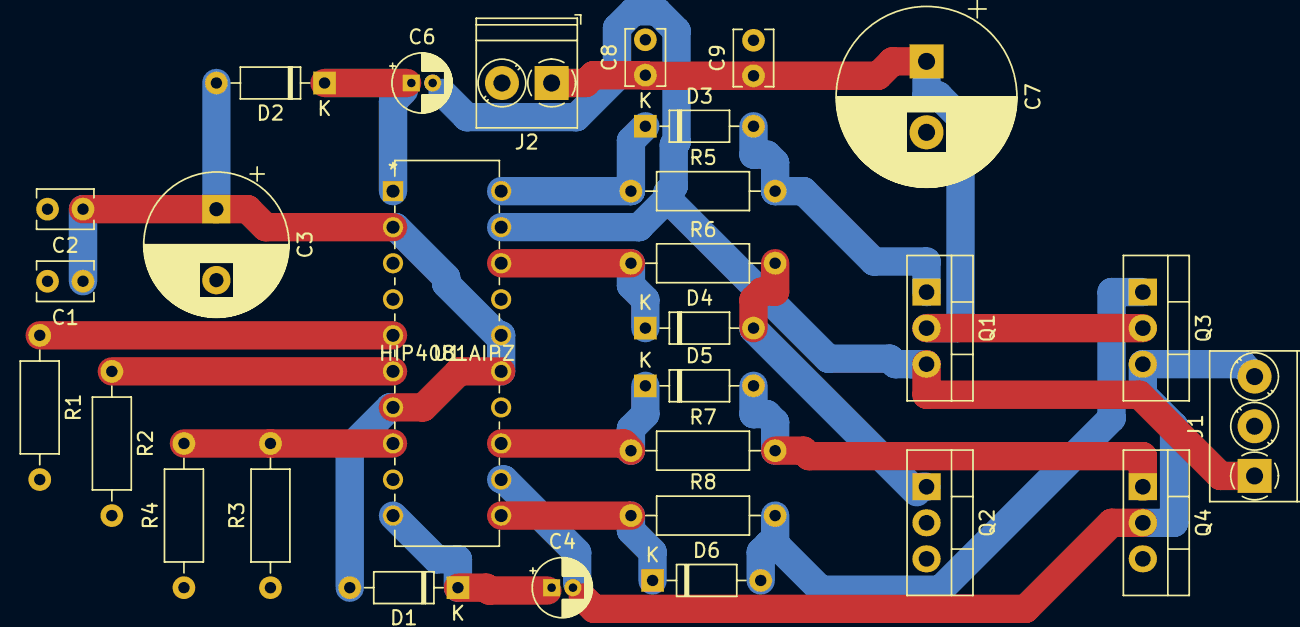
[picture p47: board power_ver_3.0.kicad_pcb from above]

Board: 2 copper layers, 29 parts (0 on the bottom side), 18 nets.
