Louis-Lhl/ECEN405_D_class_amp/schematic/filter/filter.kicad_pcb

## KiCad design schematic/filter/filter.kicad_pcb (2021-09-09)

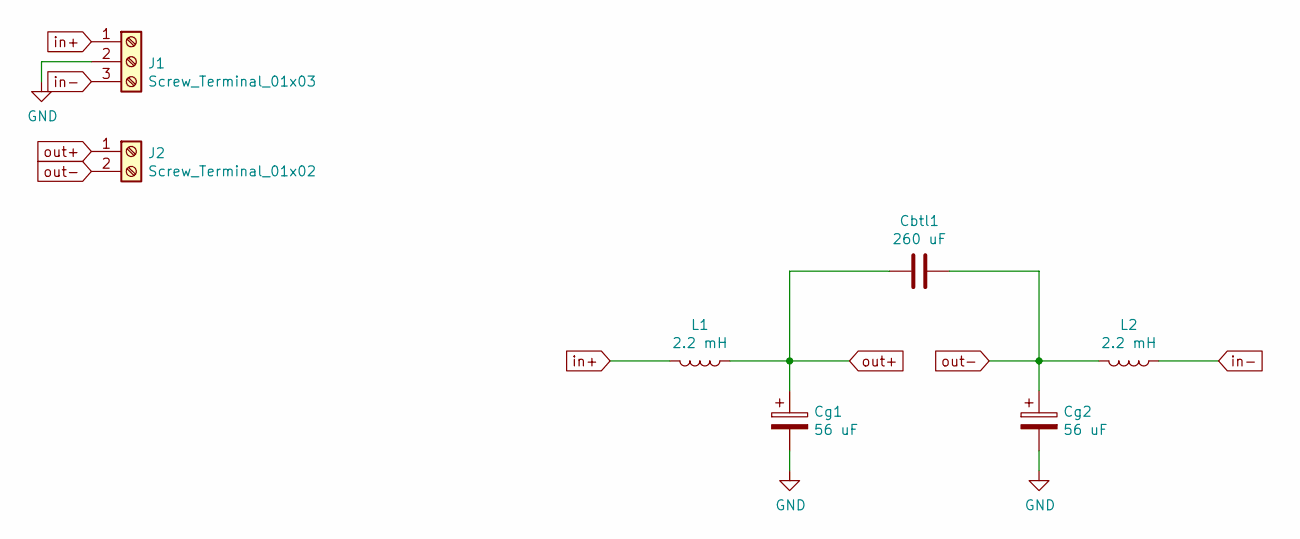
[picture p48: schematic filter.sch]

Parts:
Cbtl1: 260 uF; C_Radial_D50.00mm_P16.00mm_P37.50mm
Cg1, Cg2: 56 uF; C_Radial_D6.3mm_H11.0mm_P2.50mm
J1: Screw_Terminal_01x03; TerminalBlock_Phoenix_PT-1,5-3-3.5-H_1x03_P3.50mm_Horizontal
J2: Screw_Terminal_01x02; TerminalBlock_Phoenix_PT-1,5-2-3.5-H_1x02_P3.50mm_Horizontal
L1, L2: 2.2 mH; L_Radial_D40.6mm_P27.94mm_Vishay_IHB-4

Connections:
GND: Cg1.2, Cg2.2, J1.2
in+: J1.1, L1.2
in-: J1.3, L2.1
out+: Cbtl1.2, Cg1.1, J2.1, L1.1
out-: Cbtl1.1, Cg2.1, J2.2, L2.2

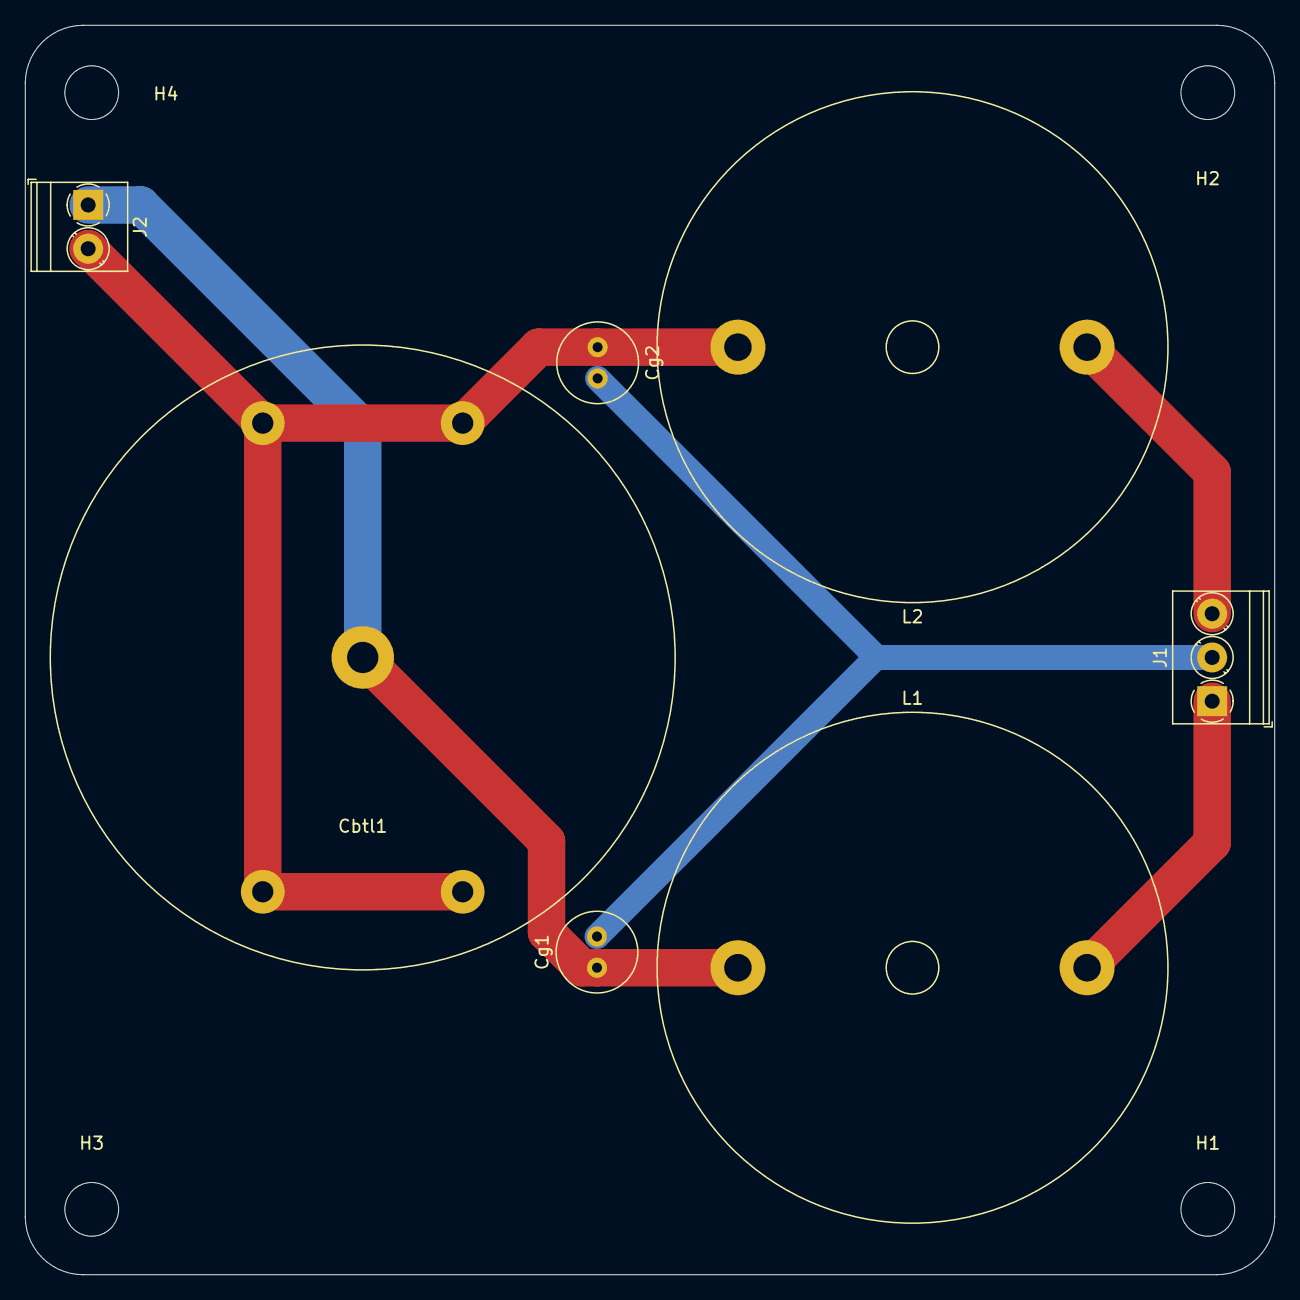
[picture p49: board filter.kicad_pcb from above]

Board: 2 copper layers, 100.0 x 100.0 mm, 11 parts (0 on the bottom side), 5 nets.

Other parts of the board:
H1, H2, H3, H4: MountingHole; MountingHole_4.3mm_M4
