Louis-Lhl/ECEN405_D_class_amp/schematic/power/power_ver_2.0/power_ver_2.0.kicad_pcb

## KiCad design schematic/power/power_ver_2.0/power_ver_2.0.kicad_pcb (2021-09-02, an earlier design)

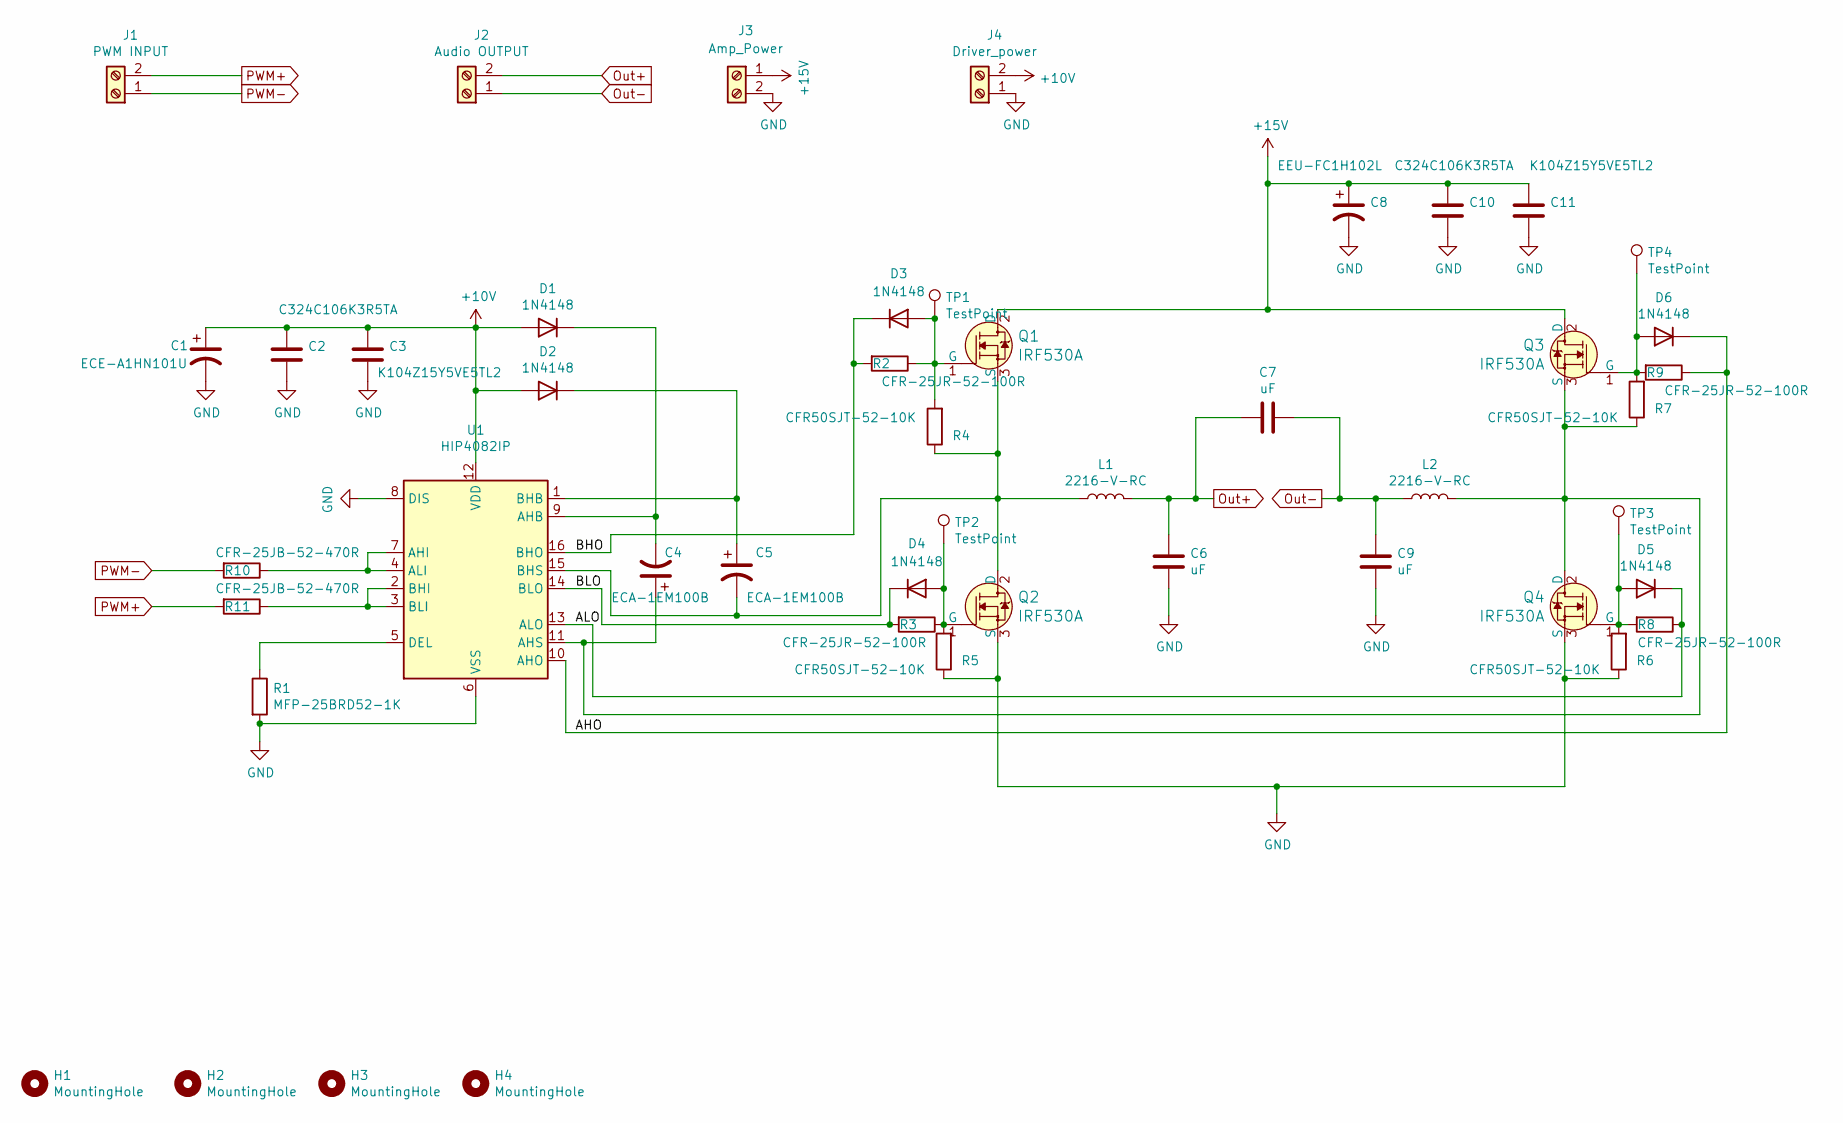
[picture p50: schematic power_ver_2.0.sch]

Parts:
C1: ECE-A1HN101U; CP_Radial_D10.0mm_P5.00mm
C2, C10: C324C106K3R5TA; C_Disc_D3.8mm_W2.6mm_P2.50mm
C3, C11: K104Z15Y5VE5TL2; C_Disc_D3.8mm_W2.6mm_P2.50mm
C4, C5: ECA-1EM100B; CP_Radial_Tantal_D5.0mm_P5.00mm
C6, C7, C9: uF; C_Radial_D10.0mm_H12.5mm_P5.00mm
C8: EEU-FC1H102L; CP_Radial_D12.5mm_P5.00mm
D1, D2, D3, D4, D5, D6: 1N4148; D_DO-35_SOD27_P7.62mm_Horizontal; Digi-Key_PN 1N4148FS-ND
H1, H2, H3, H4: MountingHole; MountingHole_4.3mm_M4
J1: PWM INPUT; TerminalBlock_Altech_AK300-2_P5.00mm; Digi-Key_PN 277-1667-ND
J2: Audio OUTPUT; TerminalBlock_Altech_AK300-2_P5.00mm; Digi-Key_PN 277-1667-ND
J3: Amp_Power; TerminalBlock_Altech_AK300-2_P5.00mm; Digi-Key_PN 277-1667-ND
J4: Driver_power; TerminalBlock_Altech_AK300-2_P5.00mm; Digi-Key_PN 277-1667-ND
L1, L2: 2216-V-RC; L_Toroid_Vertical_L24.6mm_W15.5mm_P11.44mm_Pulse_KM-4
Q1, Q2, Q3, Q4: IRF530A; TO-220-3; MPN IRF530A; Digi-Key_PN 2156-IRF530A-ND
R1: MFP-25BRD52-1K; R_Axial_DIN0207_L6.3mm_D2.5mm_P10.16mm_Horizontal
R2, R3, R8, R9: CFR-25JR-52-100R; R_Axial_DIN0207_L6.3mm_D2.5mm_P10.16mm_Horizontal
R4, R5, R6, R7: CFR50SJT-52-10K; R_Axial_DIN0207_L6.3mm_D2.5mm_P10.16mm_Horizontal
R10, R11: CFR-25JB-52-470R; R_Axial_DIN0207_L6.3mm_D2.5mm_P10.16mm_Horizontal
TP1, TP2, TP3, TP4: TestPoint; TestPoint_THTPad_D2.0mm_Drill1.0mm
U1: HIP4082IP; DIP-16_W7.62mm

Connections:
+10V: C1.1, C2.1, C3.1, D1.2 (A), D2.2 (A), J4.2, U1.12 (VDD)
+15V: C8.1, C10.1, C11.1, J3.1, Q1.2 (D), Q3.2 (D)
/AHO: D6.1 (K), R9.1, U1.10 (AHO)
/ALO: D5.1 (K), R8.1, U1.13 (ALO)
/BHO: D3.1 (K), R2.2, U1.16 (BHO)
/BLO: D4.1 (K), R3.2, U1.14 (BLO)
GND: C1.2, C2.2, C3.2, C6.2, C8.2, C9.2, C10.2, C11.2, J3.2, J4.1, Q2.3 (S), Q4.3 (S), R1.2, R5.1, R6.1, U1.6 (VSS), U1.8 (DIS)
unnamed: C4.1, L2.2, Q3.3 (S), Q4.2 (D), R7.1, U1.11 (AHS)
unnamed: C4.2, D1.1 (K), U1.9 (AHB)
unnamed: C5.1, D2.1 (K), U1.1 (BHB)
unnamed: C5.2, L1.1, Q1.3 (S), Q2.2 (D), R4.1, U1.15 (BHS)
unnamed: D3.2 (A), Q1.1 (G), R2.1, R4.2, TP1.1
unnamed: D4.2 (A), Q2.1 (G), R3.1, R5.2, TP2.1
unnamed: D5.2 (A), Q4.1 (G), R6.2, R8.2, TP3.1
unnamed: D6.2 (A), Q3.1 (G), R7.2, R9.2, TP4.1
unnamed: R1.1, U1.5 (DEL)
unnamed: R10.1, U1.4 (ALI), U1.7 (AHI)
unnamed: R11.1, U1.2 (BHI), U1.3 (BLI)
Out+: C6.1, C7.2, J2.2, L1.2
Out-: C7.1, C9.1, J2.1, L2.1
PWM+: J1.2, R11.2
PWM-: J1.1, R10.2

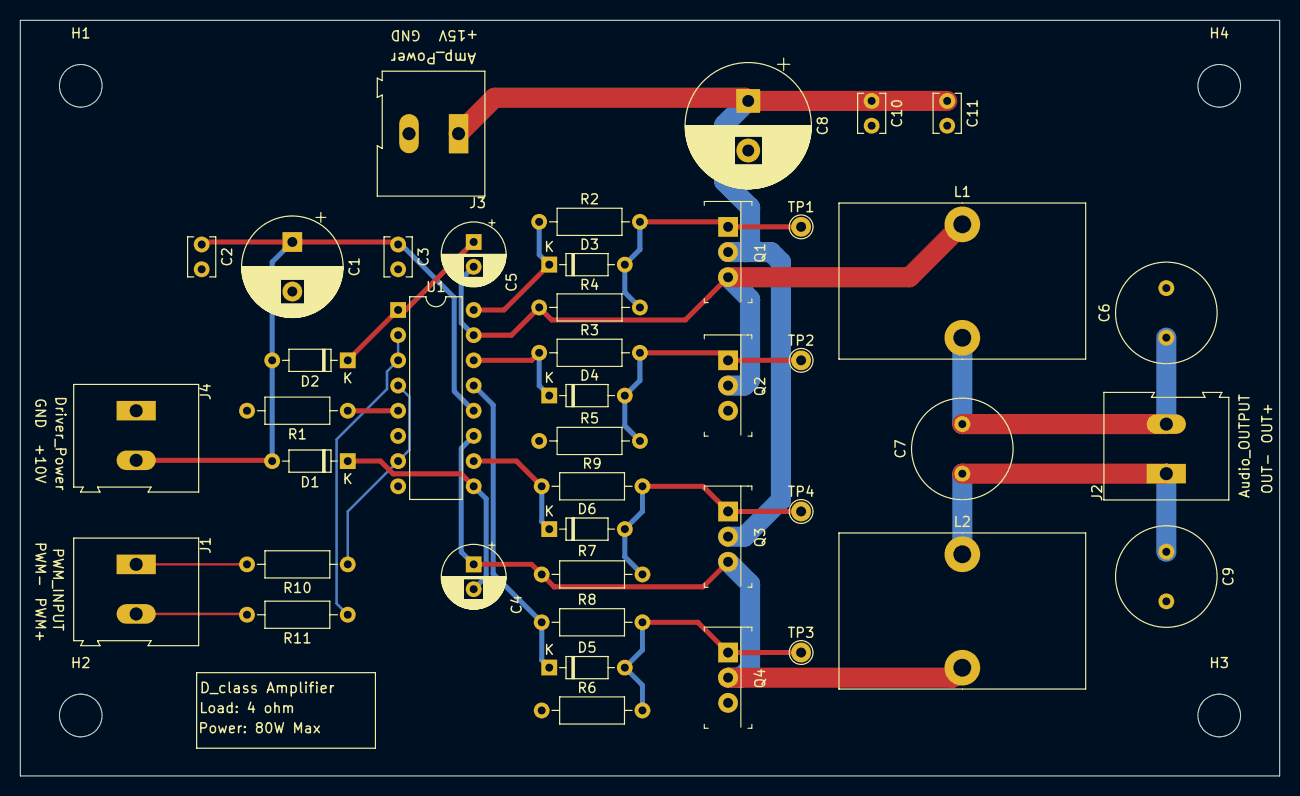
[picture p51: board power_ver_2.0.kicad_pcb from above]

Board: 2 copper layers, 127.0 x 76.2 mm, 47 parts (0 on the bottom side), 22 nets.
