Louis-Lhl/ECEN405_D_class_amp/schematic/power/power/power.kicad_pcb

## KiCad design schematic/power/power/power.kicad_pcb (2021-08-31, an earlier design)

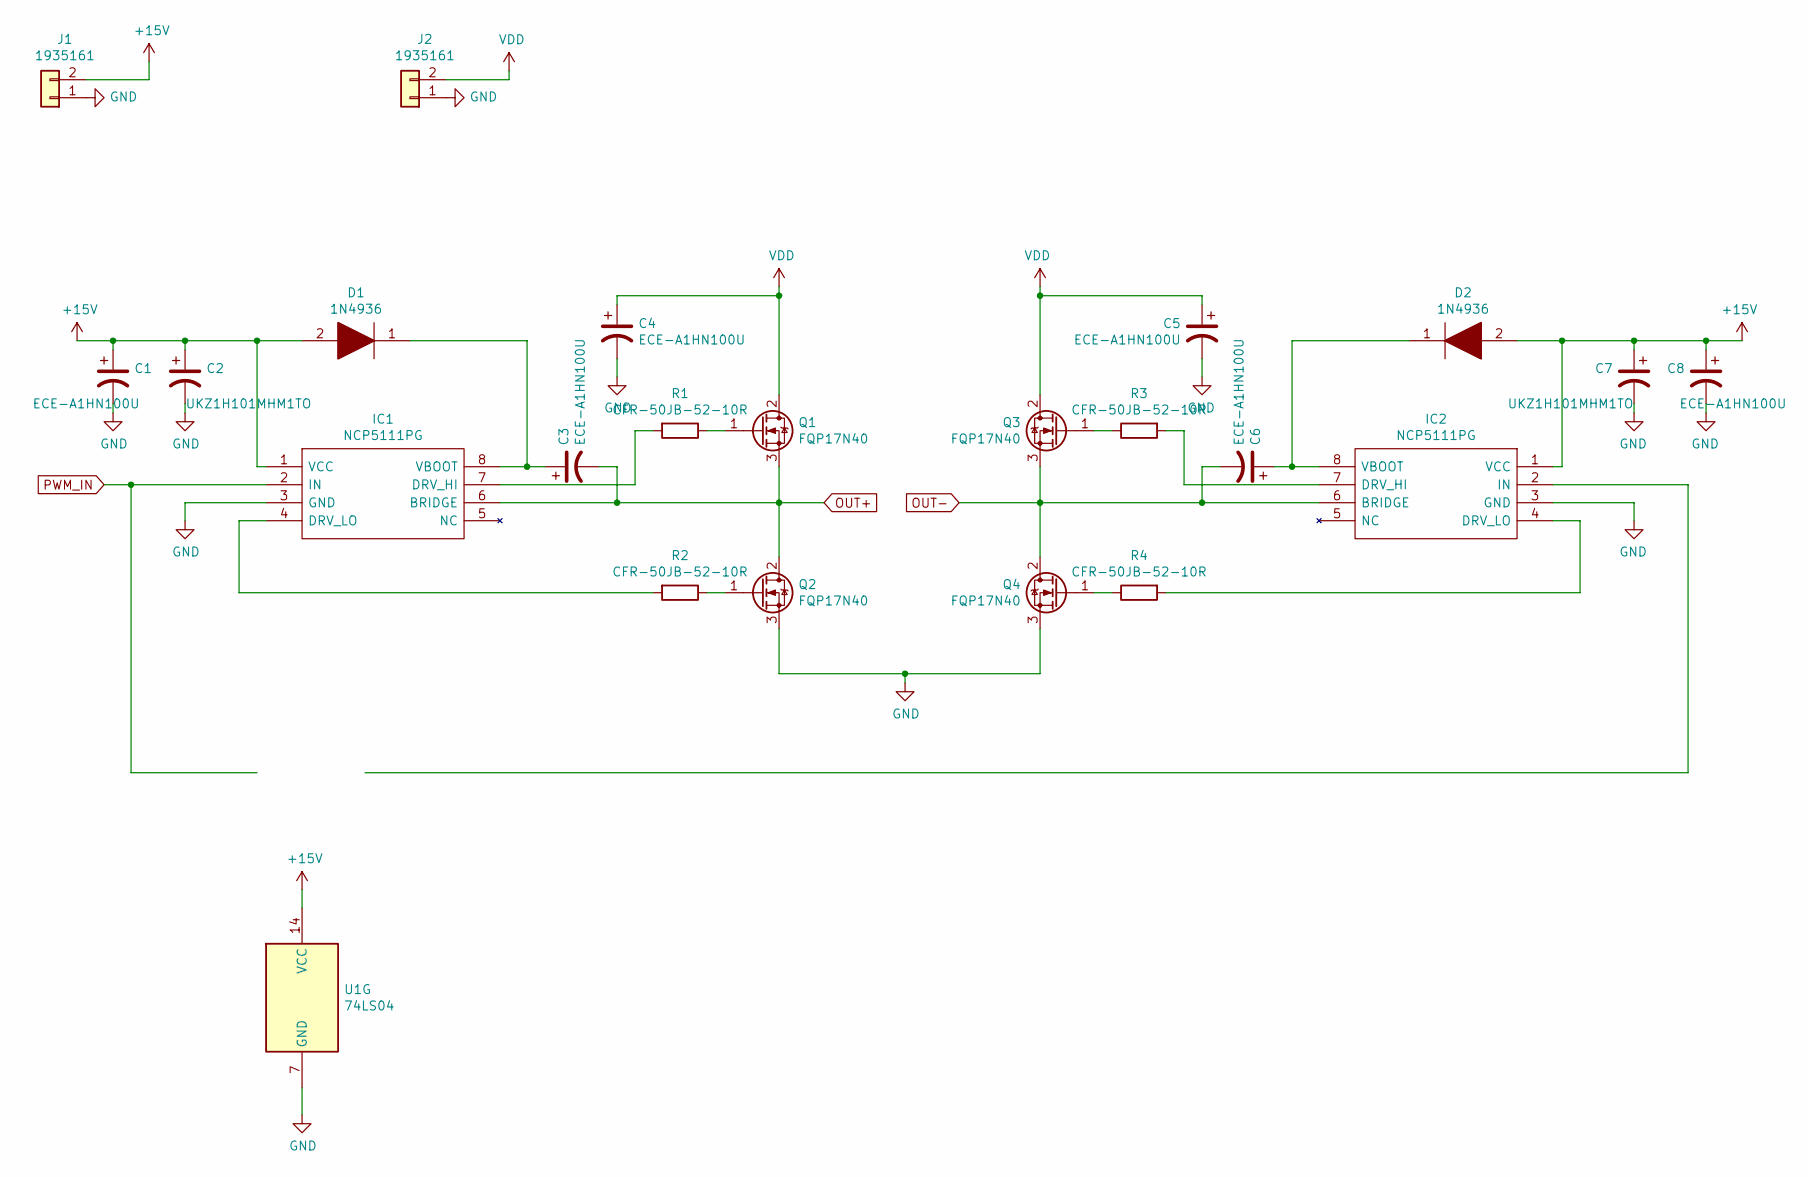
[picture p52: schematic power.sch]

Parts:
C1, C3, C4, C5, C6, C8: ECE-A1HN100U; CP_Radial_D6.3mm_P2.50mm
C2, C7: UKZ1H101MHM1TO; CP_Radial_D12.5mm_P5.00mm
D1, D2: 1N4936; DIOAD1405W86L465D235; Manufacturer_Part_Number 1N4936; Mouser Part Number 512-1N4936
IC1, IC2: NCP5111PG; DIP794W56P254L959H533Q8N; Manufacturer_Part_Number NCP5111PG; Mouser Part Number 863-NCP5111PG
J1, J2: 1935161; TerminalBlock_Altech_AK300-2_P5.00mm
Q1, Q2, Q3, Q4: FQP17N40; TO254P470X990X1910-3P
R1, R2, R3, R4: CFR-50JB-52-10R; R_Axial_DIN0309_L9.0mm_D3.2mm_P12.70mm_Horizontal
U1: 74LS04; DIP-14_W7.62mm

Connections:
+15V: C1.1, C2.1, C7.1, C8.1, D1.2, D2.2, IC1.1 (VCC), IC2.1 (VCC), J1.2, U1.14 (VCC)
GND: C1.2, C2.2, C4.2, C5.2, C7.2, C8.2, IC1.3 (GND), IC2.3 (GND), J1.1, J2.1, Q2.3 (S), Q4.3 (S), U1.7 (GND)
unnamed: C3.1, D1.1, IC1.8 (VBOOT)
unnamed: C6.1, D2.1, IC2.8 (VBOOT)
unnamed: IC1.4 (DRV_LO), R2.2
unnamed: IC1.7 (DRV_HI), R1.2
unnamed: IC2.2 (IN), U1.12
unnamed: IC2.4 (DRV_LO), R4.2
unnamed: IC2.7 (DRV_HI), R3.2
unnamed: Q1.1 (G), R1.1
unnamed: Q2.1 (G), R2.1
unnamed: Q3.1 (G), R3.1
unnamed: Q4.1 (G), R4.1
OUT+: C3.2, IC1.6 (BRIDGE), Q1.3 (S), Q2.2 (D)
OUT-: C6.2, IC2.6 (BRIDGE), Q3.3 (S), Q4.2 (D)
PWM_IN: IC1.2 (IN), U1.13
VDD: C4.1, C5.1, J2.2, Q1.2 (D), Q3.2 (D)

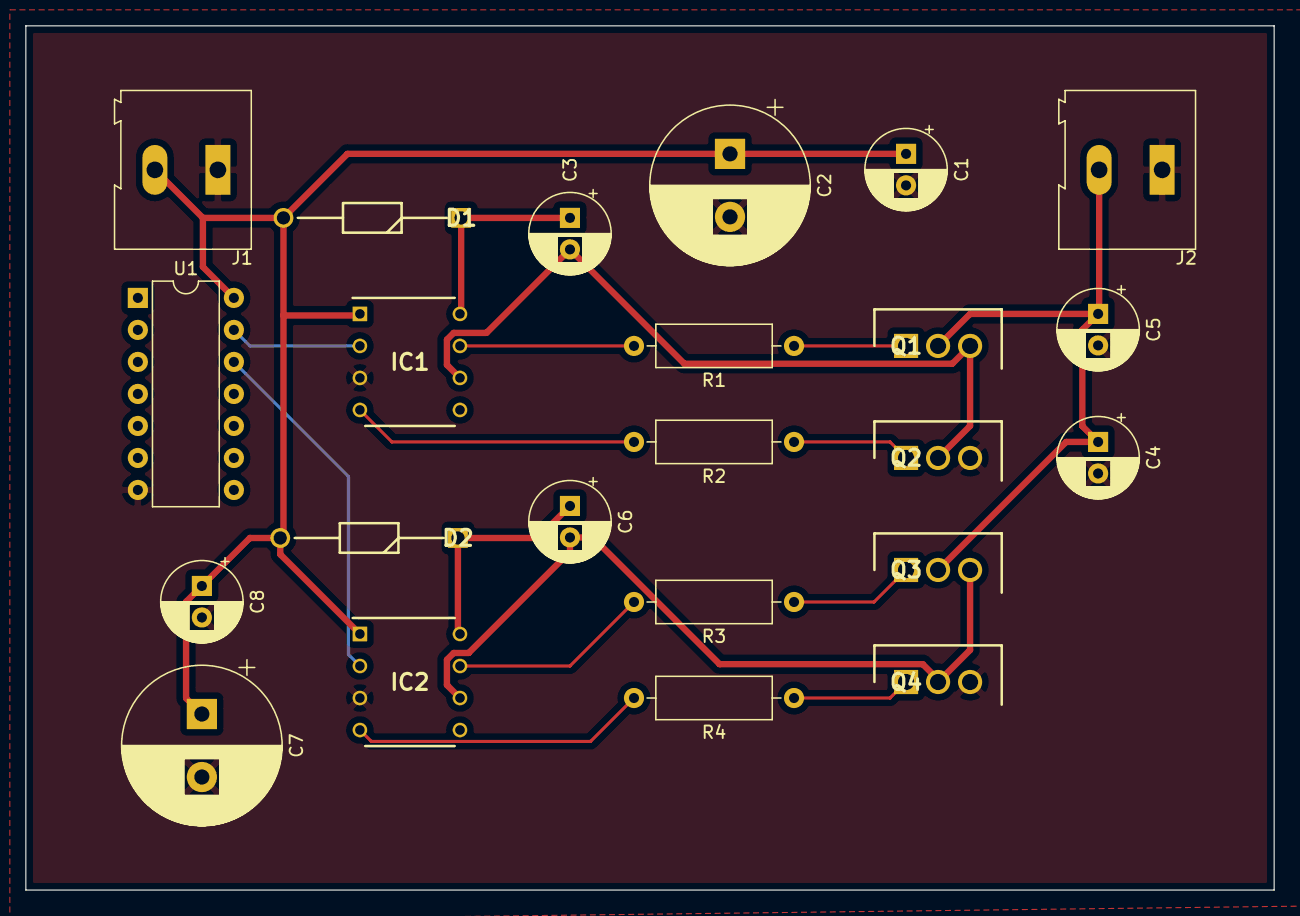
[picture p53: board power.kicad_pcb from above]

Board: 2 copper layers, 99.1 x 68.6 mm, 23 parts (0 on the bottom side), 17 nets.
