Louis-Lhl/ECEN405_D_class_amp/(commit log)

2021-08-10 init repo
    [power.kicad_pcb, power.sch]
2021-08-19 full bridge amplifier schematic
    [power.sch]
2021-08-19 Added connectors and filter section
    [power.sch]
2021-08-19 Added input section
    [inputStage.kicad_pcb, inputStage.sch]
2021-08-20 assign part number to power schematic
    [power.sch]
2021-08-20 Added small decoupling caps
    [inputStage.kicad_pcb, inputStage.sch]
2021-08-20 Updated terminals and added IC labels
    [inputStage.kicad_pcb, inputStage.sch]
2021-08-20 initial PCB layout for power
    [power.sch]
2021-08-20 Terminal updates
    [inputStage.sch]
2021-08-31 add power ver 2
    [power.kicad_pcb, power.sch, power_ver_2.0.kicad_pcb, power_ver_2.0.sch]
2021-08-31 ver2 pcb layout
    [power_ver_2.0.kicad_pcb]
2021-09-01 auto roulting
    [power_ver_2.0.dsn, power_ver_2.0.kicad_pcb]
2021-09-02 finish pcb trace layout
    [power_ver_2.0.kicad_pcb, power_ver_2.0.sch]
2021-09-02 add mounting hole, test point
    [power_ver_2.0.kicad_pcb, power_ver_2.0.sch]
2021-09-02 add BOM
    [power_ver_2.0.csv, power_ver_2.0.kicad_pcb, power_ver_2.0.sch, power_ver_2.0.xlsx]
2021-09-02 add joint pcb proj
    [joint_pcb.kicad_pcb, joint_pcb.sch, power_ver_2.0_BOM.csv]
2021-09-02 Added spice model for output filter
2021-09-03 joint pcb power section
    [input_stage.sch, joint_pcb.kicad_pcb, low_pass_filter_stage.sch, power_stage.sch, power_ver_2.0.csv, power_ver_2.0.sch]
2021-09-03 add trace
    [joint_pcb.dsn, joint_pcb.kicad_pcb]
2021-09-08 Fixed PCB
    [input_stage.sch, joint_pcb.kicad_pcb, low_pass_filter_stage.sch, power_stage.sch]
2021-09-09 Created filter section project
    [filter-B_Cu.gbl, filter-B_Mask.gbs, filter-B_Paste.gbp, filter-B_SilkS.gbo, filter-Edge_Cuts.gm1, filter-F_Cu.gtl, filter-F_Mask.gts, filter-F_Paste.gtp]
2021-09-09 Added film cap footprint
2021-09-09 Generated gerber files
    [joint_pcb-B_Cu.gbl, joint_pcb-B_Mask.gbs, joint_pcb-B_Paste.gbp, joint_pcb-B_SilkS.gbo, joint_pcb-Edge_Cuts.gm1, joint_pcb-F_Cu.gtl, joint_pcb-F_Mask.gts, joint_pcb-F_Paste.gtp]
2021-09-09 Added ground ouput, aligned mounting holes, rounded corners
    [joint_pcb.kicad_pcb]
2021-09-10 move geber files to manufacture folder and add BOM csv file
    [Class D Amp BoM.csv, power_ver_2.0_BOM.csv]
2021-09-10 create a zip file
    [filter-B_Cu.gbl, filter-B_Mask.gbs, filter-B_Paste.gbp, filter-B_SilkS.gbo, filter-Edge_Cuts.gm1, filter-F_Cu.gtl, filter-F_Mask.gts, filter-F_Paste.gtp]
2021-09-13 power 3.0 schematic and pcb layout
    [power_ver_2.0.csv, power_ver_3.0.kicad_pcb, power_ver_3.0.sch]
2021-09-13 power 3.0 pcb layout
    [input_stage.sch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]
2021-09-13 finish layout for PCB
    [input_stage.sch, joint_pcb.sch, power_stage.sch, power_ver_3.0.dsn, power_ver_3.0.kicad_pcb]
2021-09-13 connect up 10V
    [input_stage.sch, joint_pcb.kicad_pcb, joint_pcb.sch, power_stage.sch, power_ver_3.0.kicad_pcb, power_ver_3.0.sch]
2021-09-13 add text and zoon
    [joint_pcb.kicad_pcb]
2021-09-13 update bom
    [Class D Amp BoM.csv]
2021-09-13 Removed thermal vias from ADA4981
    [joint_pcb-B_Cu.gbl, joint_pcb-B_Mask.gbs, joint_pcb-B_Paste.gbp, joint_pcb-B_SilkS.gbo, joint_pcb-Edge_Cuts.gm1, joint_pcb-F_Cu.gtl, joint_pcb-F_Mask.gts, joint_pcb-F_Paste.gtp]
2021-09-13 add manufacture zip
    [joint_pcb-B_Cu.gbl, joint_pcb-B_Mask.gbs, joint_pcb-B_Paste.gbp, joint_pcb-B_SilkS.gbo, joint_pcb-Edge_Cuts.gm1, joint_pcb-F_Cu.gtl, joint_pcb-F_Mask.gts, joint_pcb-F_Paste.gtp]
2021-11-02 Add power section scope measurement
    [F0000CH1.CSV, F0001CH1.CSV, F0002CH1.CSV, F0003CH1.CSV, F0004CH1.CSV, F0004CH2.CSV, F0005CH1.CSV, F0005CH2.CSV]
2021-11-02 output filter results
2021-11-04 add description for power stage results
    [F0000CH1.CSV, F0001CH1.CSV, F0002CH1.CSV, F0003CH1.CSV, F0004CH1.CSV, F0004CH2.CSV, F0005CH1.CSV, F0005CH2.CSV]
