Louis-Lhl/ECEN405_D_class_amp/(notices)

Notices in the files:
parts and their libraries:
Copyright 2021 Accelerated Designs. All rights reserved.
